Capful/Graduation_Project/堆肥发酵塔设计/PPT 素材/有加强_转.gif

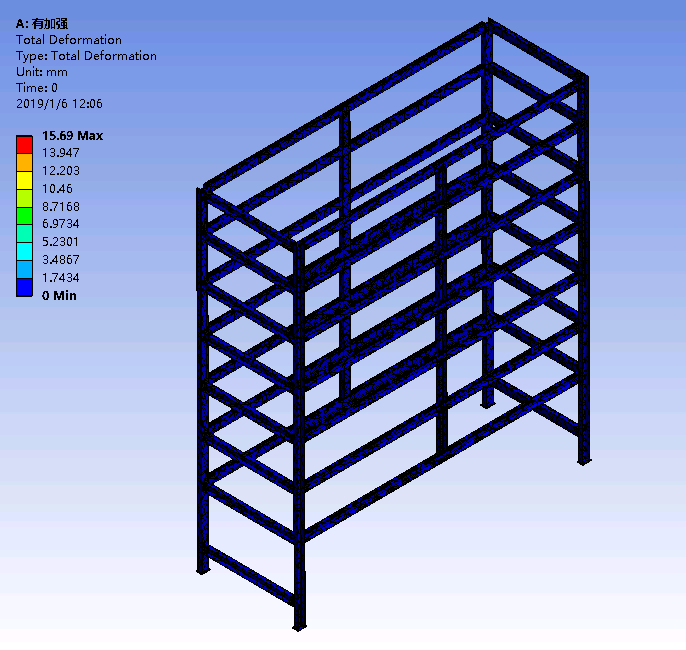
堆肥发酵塔设计/PPT 素材/有加强_转.gif
