Capful/Graduation_Project/堆肥发酵塔设计/ANSYS分析/截图/受力面.png

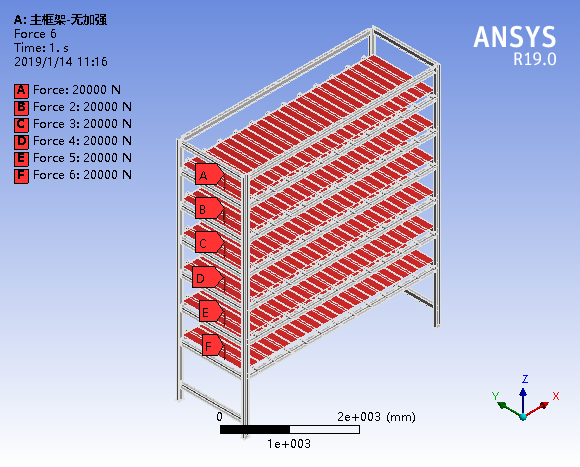
堆肥发酵塔设计/ANSYS分析/截图/受力面.png
