Capful/Graduation_Project/堆肥发酵塔设计/ANSYS分析/截图/总变形-无加强.png

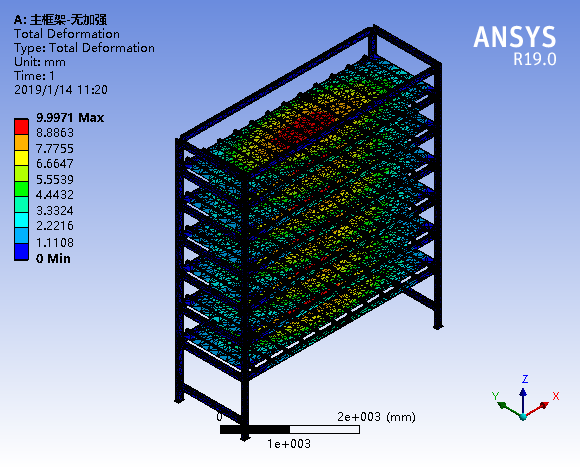
堆肥发酵塔设计/ANSYS分析/截图/总变形-无加强.png
