Capful/Graduation_Project/堆肥发酵塔设计/PPT 素材/QQ截图20190106104016.png

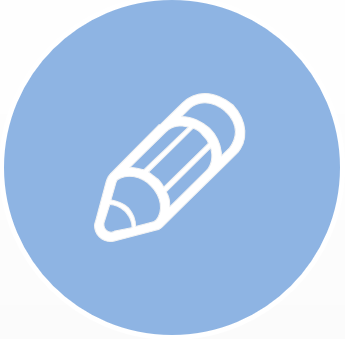
堆肥发酵塔设计/PPT 素材/QQ截图20190106104016.png
