Capful/Graduation_Project/堆肥发酵塔设计/PPT 素材/timg.jpg

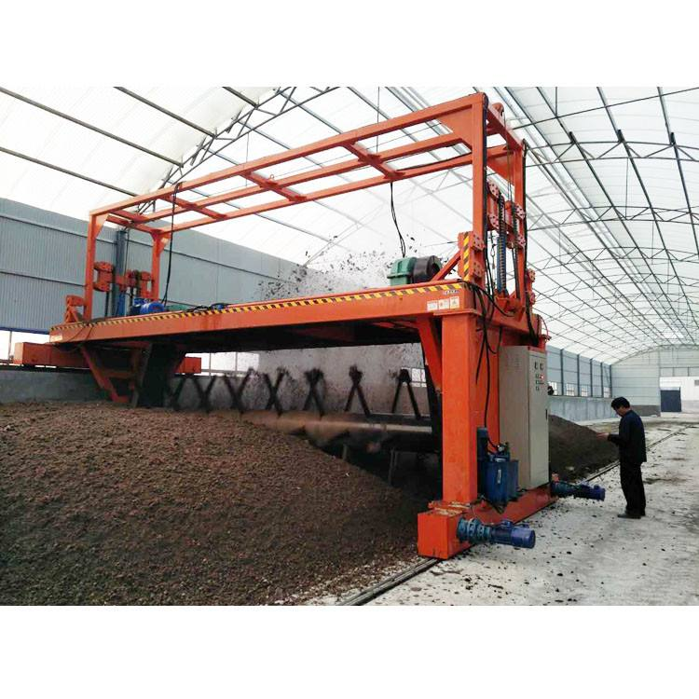
堆肥发酵塔设计/PPT 素材/timg.jpg
