Capful/Graduation_Project/堆肥发酵塔设计/PPT 素材/附件13：配色10 - 副本.png

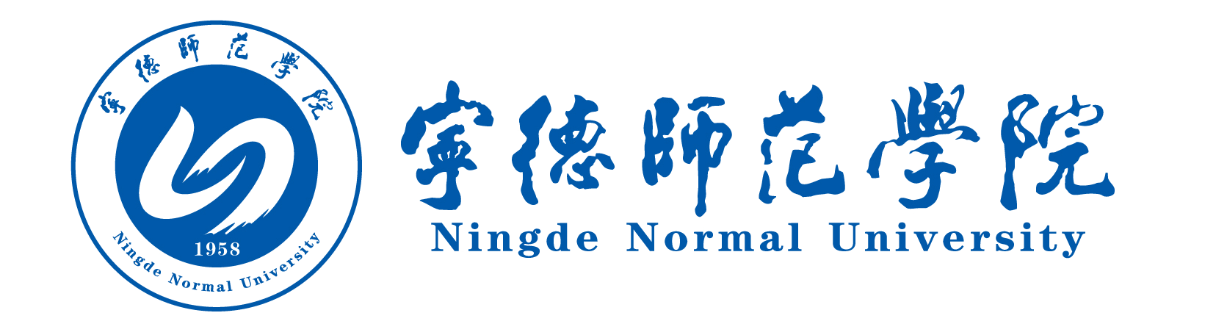
堆肥发酵塔设计/PPT 素材/附件13：配色10 - 副本.png
