Capful/Graduation_Project/堆肥发酵塔设计/堆肥发酵塔2D图/2D PDF/FJT-01001(横支架).jpg

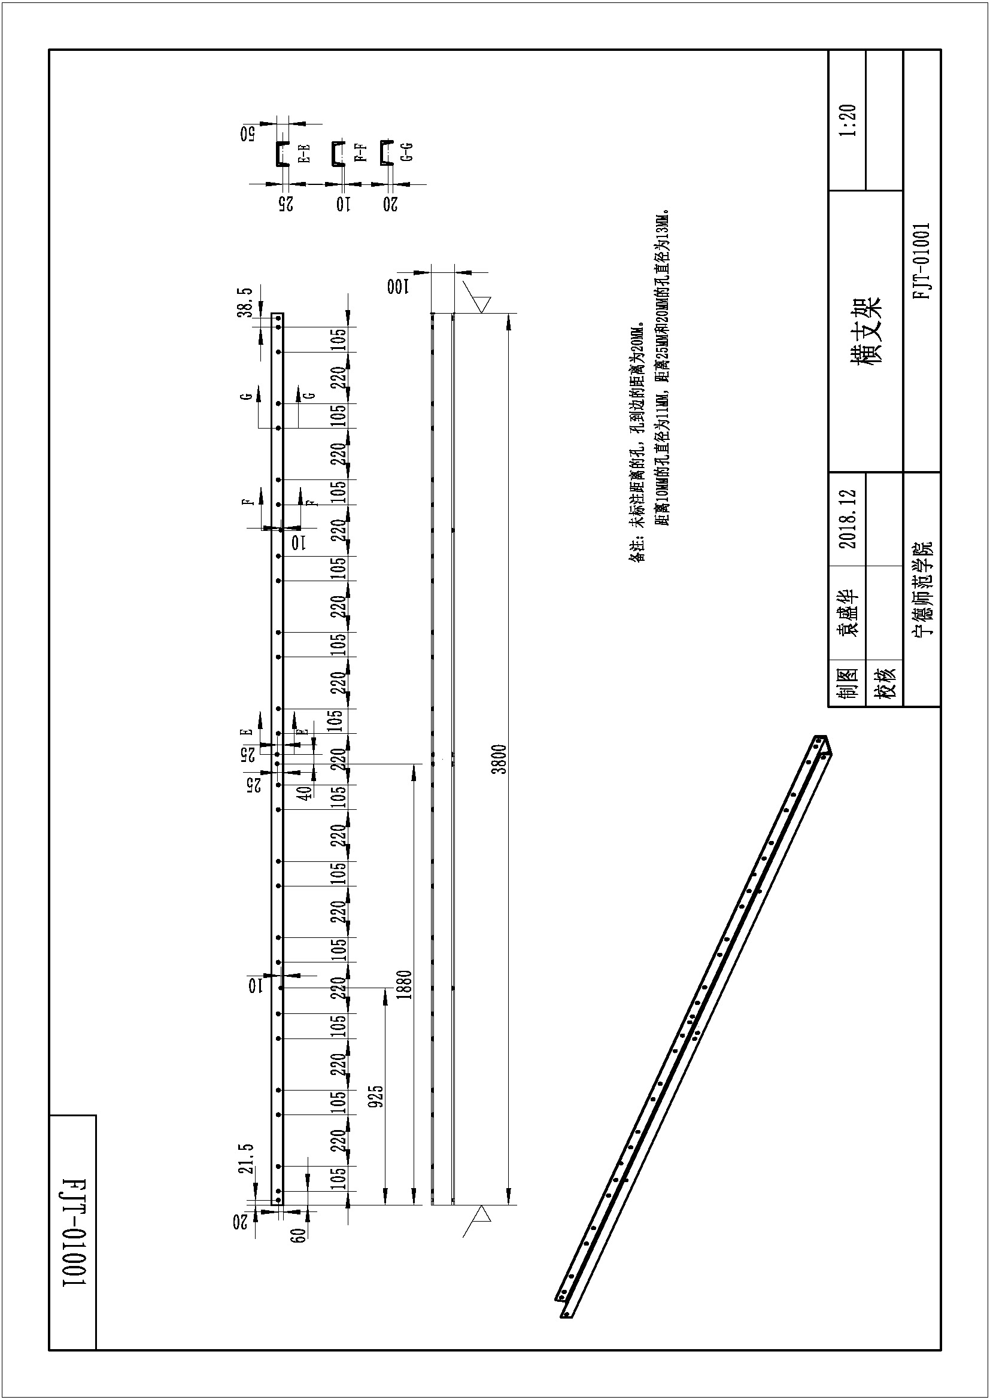
堆肥发酵塔设计/堆肥发酵塔2D图/2D PDF/FJT-01001(横支架).jpg
