Capful/Graduation_Project/堆肥发酵塔设计/堆肥发酵塔2D图/2D PDF/FJT-02100(摆动叶A).jpg

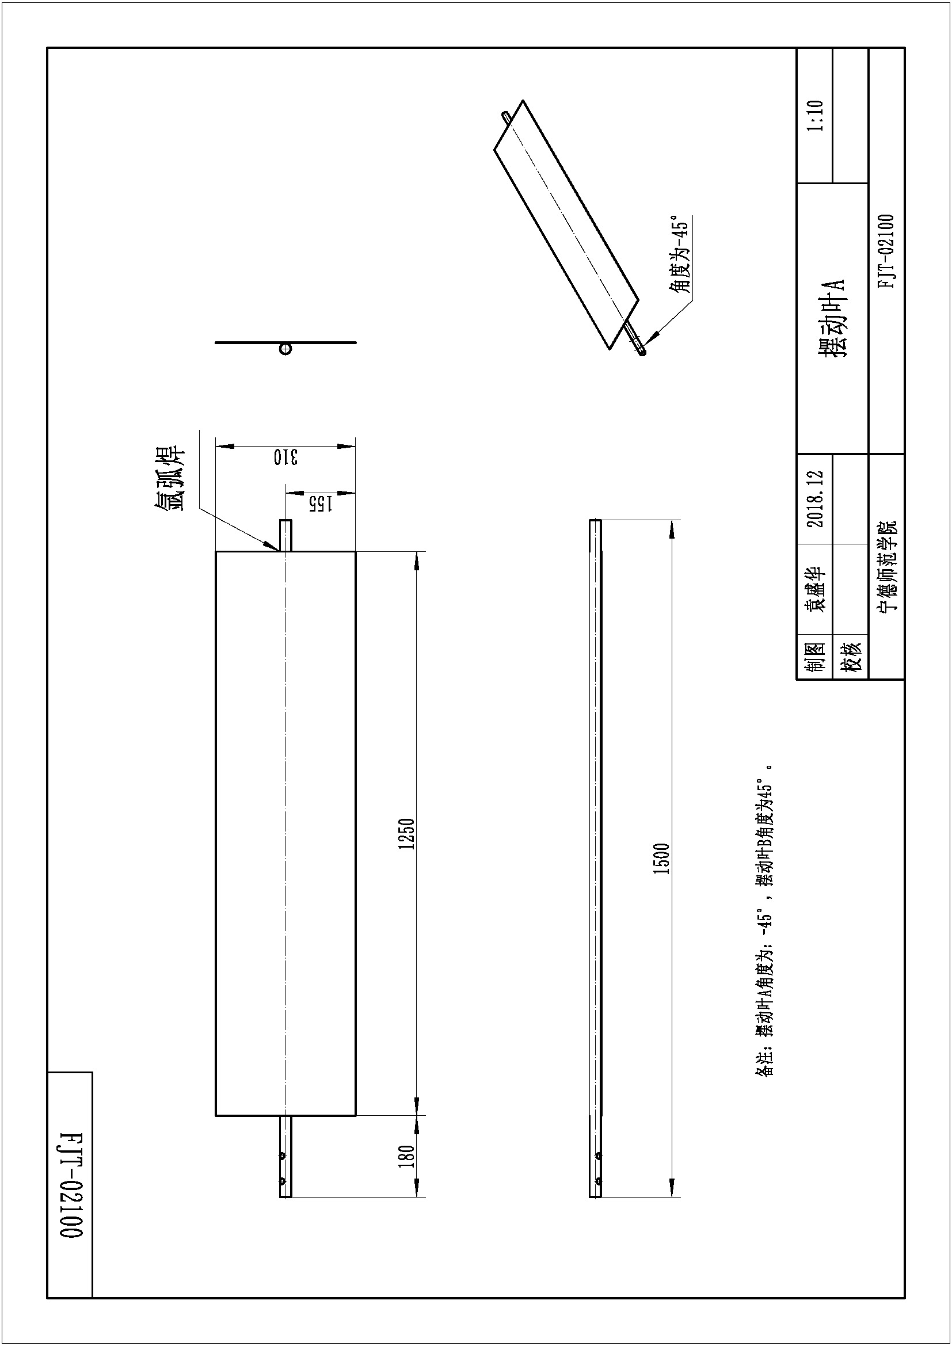
堆肥发酵塔设计/堆肥发酵塔2D图/2D PDF/FJT-02100(摆动叶A).jpg
