Capful/Graduation_Project/堆肥发酵塔设计/模型截图/右支架.png

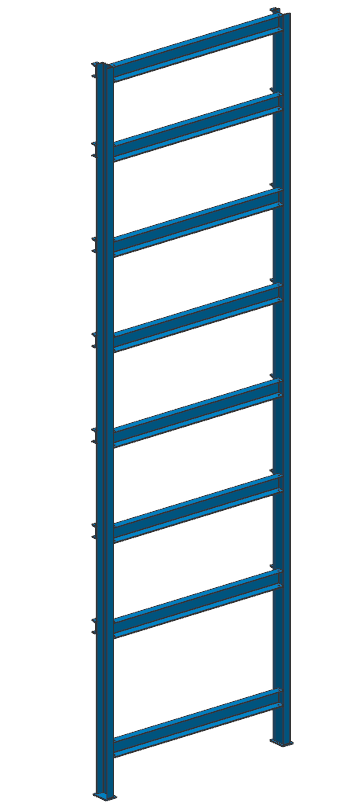
堆肥发酵塔设计/模型截图/右支架.png
