Capful/Graduation_Project/堆肥发酵塔设计/模型截图/左右支架2D.png

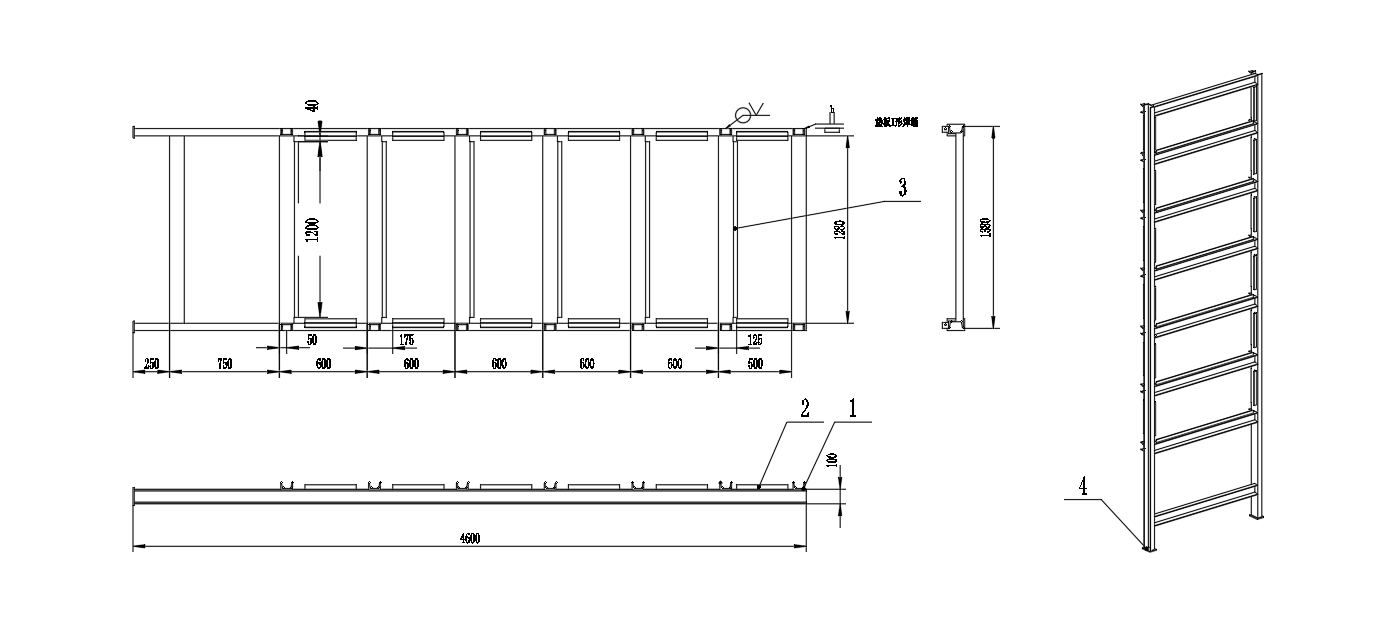
堆肥发酵塔设计/模型截图/左右支架2D.png
