Capful/Graduation_Project/堆肥发酵塔设计/模型截图/机构简图2.png

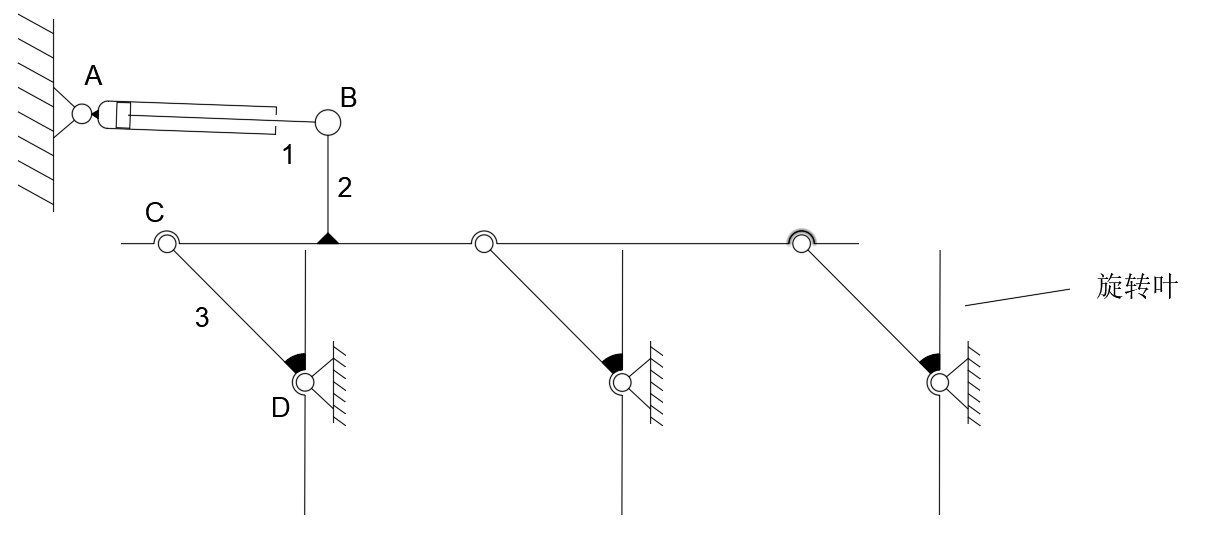
堆肥发酵塔设计/模型截图/机构简图2.png
