Capful/Graduation_Project/堆肥发酵塔设计/模型截图/横支架连接.png

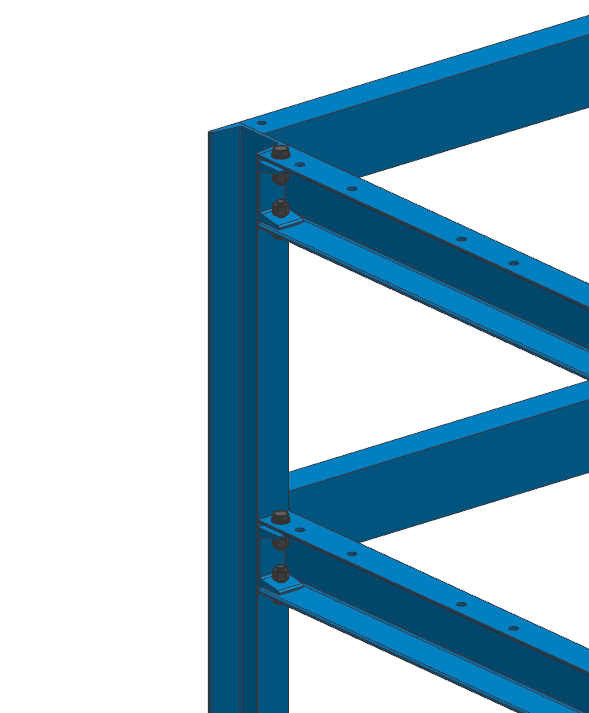
堆肥发酵塔设计/模型截图/横支架连接.png
