Capful/Graduation_Project/堆肥发酵塔设计/模型截图/油缸伸出长度.png

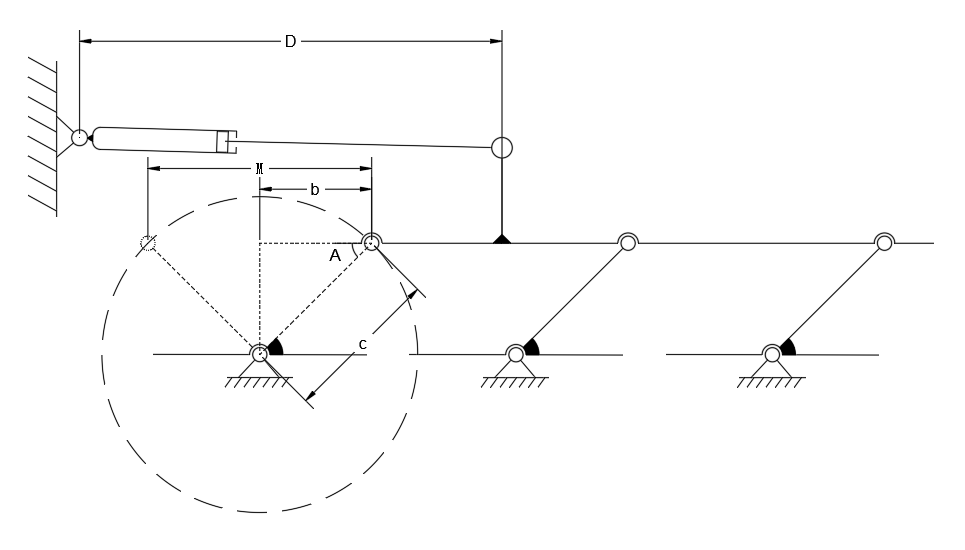
堆肥发酵塔设计/模型截图/油缸伸出长度.png
