Capful/Graduation_Project/堆肥发酵塔设计/模型截图/液压油缸2d2.png

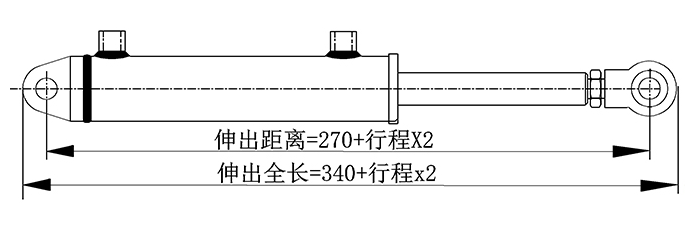
堆肥发酵塔设计/模型截图/液压油缸2d2.png
