Capful/Graduation_Project/堆肥发酵塔设计/模型截图/示意图.png

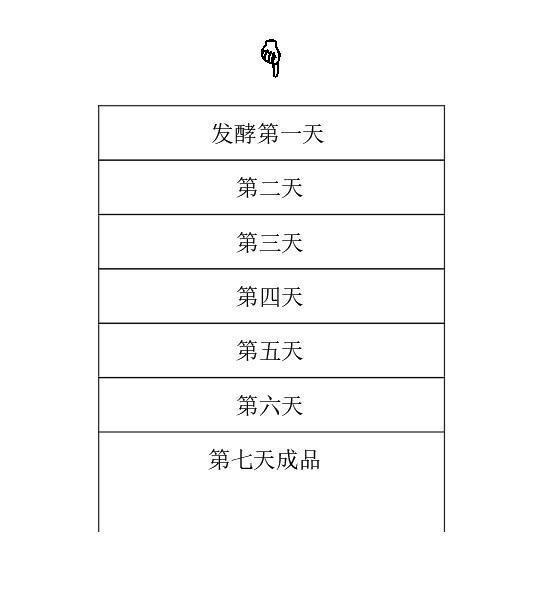
堆肥发酵塔设计/模型截图/示意图.png
