Capful/Graduation_Project/堆肥发酵塔设计/模型截图/移动杆.png

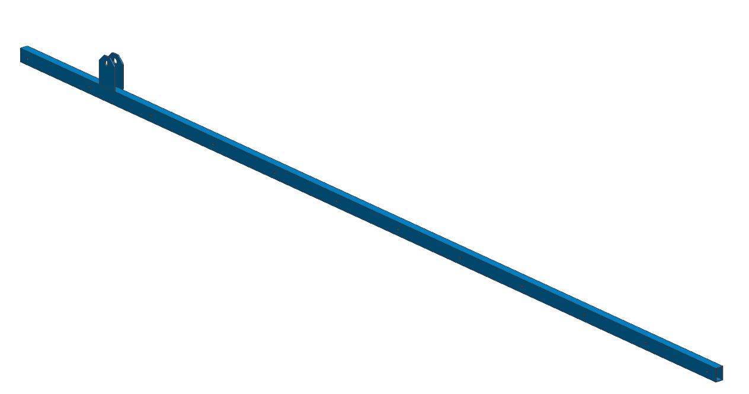
堆肥发酵塔设计/模型截图/移动杆.png
