Capful/Graduation_Project/堆肥发酵塔设计/模型截图/螺栓固定.png

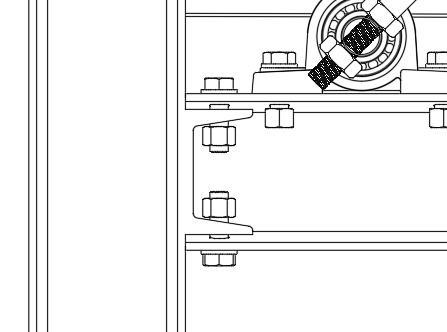
堆肥发酵塔设计/模型截图/螺栓固定.png
