Capful/Graduation_Project/堆肥发酵塔设计/模型截图/运动2D.png

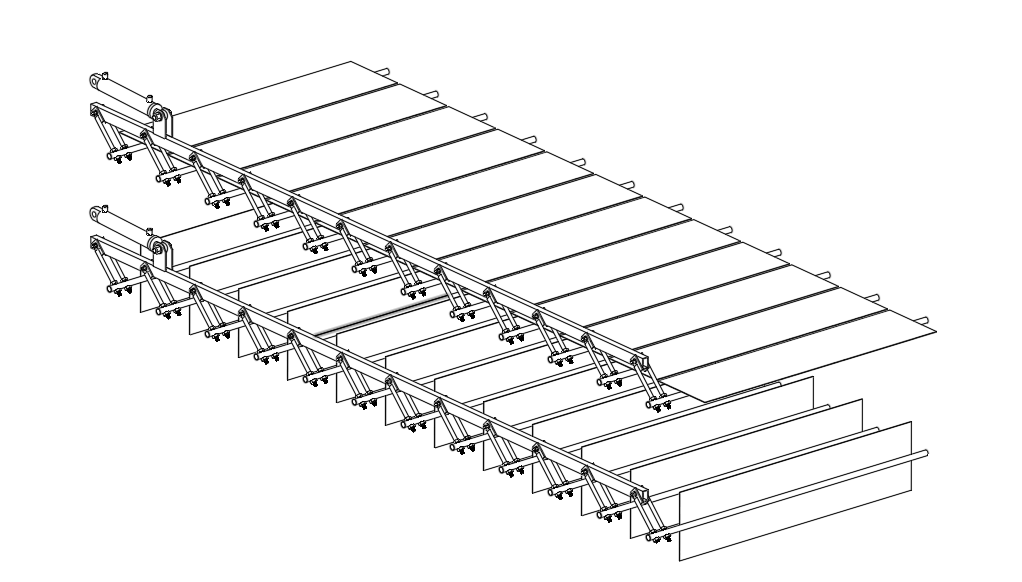
堆肥发酵塔设计/模型截图/运动2D.png
