Capful/Graduation_Project/(list of files, cad)

Other CAD files:
堆肥发酵塔设计/堆肥发酵塔2D图/AutoCAD 2018/FJT-01300(竖支架).dwg
堆肥发酵塔设计/模型截图/自由度.dwg
堆肥发酵塔设计/堆肥发酵塔2D图/AutoCAD 2018/FJT-01200(左支架).dwg
堆肥发酵塔设计/模型截图/卸料设计方案.dwg
堆肥发酵塔设计/堆肥发酵塔2D图/AutoCAD 2018/FJT-01100(右支架).dwg
堆肥发酵塔设计/模型截图/示意图.dwg
堆肥发酵塔设计/堆肥发酵塔2D图/AutoCAD 2018/FJT-01104(垫片).dwg
堆肥发酵塔设计/堆肥发酵塔2D图/AutoCAD 2018/FJT-01101(支架固定块).dwg
堆肥发酵塔设计/堆肥发酵塔2D图/AutoCAD 2018/FJT-02200(摆动叶A-B).dwg
堆肥发酵塔设计/堆肥发酵塔2D图/AutoCAD 2018/FJT-01000(主框架装配).dwg
堆肥发酵塔设计/堆肥发酵塔2D图/AutoCAD 2018/FJT-01002(挡板固定片,横支架).dwg
堆肥发酵塔设计/堆肥发酵塔2D图/AutoCAD 2018/FJT-01005(挡板1).dwg
堆肥发酵塔设计/堆肥发酵塔2D图/AutoCAD 2018/FJT-01102(挡板固定板).dwg
堆肥发酵塔设计/堆肥发酵塔2D图/AutoCAD 2018/FJT-01004(挡板).dwg
堆肥发酵塔设计/ANSYS分析/ANSYS_主框架_加强.prt
堆肥发酵塔设计/ANSYS分析/ANSYS_主框架_无加强.prt
堆肥发酵塔设计/堆肥发酵塔三维模型/3D图/UG12-堆肥发酵塔3D装配图/3D堆肥发酵塔.prt
堆肥发酵塔设计/堆肥发酵塔三维模型/3D图/UG12-堆肥发酵塔3D装配图/63X35X250液压缸.prt
堆肥发酵塔设计/堆肥发酵塔三维模型/3D图/UG12-堆肥发酵塔3D装配图/M10X20螺栓.prt
堆肥发酵塔设计/堆肥发酵塔三维模型/3D图/UG12-堆肥发酵塔3D装配图/M10X30螺杆.prt
堆肥发酵塔设计/堆肥发酵塔三维模型/3D图/UG12-堆肥发酵塔3D装配图/M10X30螺栓-2.prt
堆肥发酵塔设计/堆肥发酵塔三维模型/3D图/UG12-堆肥发酵塔3D装配图/M10X30螺栓-3.prt
堆肥发酵塔设计/堆肥发酵塔三维模型/3D图/UG12-堆肥发酵塔3D装配图/M10X30螺栓.prt
堆肥发酵塔设计/堆肥发酵塔三维模型/3D图/UG12-堆肥发酵塔3D装配图/M10X40螺杆.prt
堆肥发酵塔设计/堆肥发酵塔三维模型/3D图/UG12-堆肥发酵塔3D装配图/M10X40螺栓.prt
堆肥发酵塔设计/堆肥发酵塔三维模型/3D图/UG12-堆肥发酵塔3D装配图/M10X50螺栓.prt
堆肥发酵塔设计/堆肥发酵塔三维模型/3D图/UG12-堆肥发酵塔3D装配图/M10X60螺杆.prt
堆肥发酵塔设计/堆肥发酵塔三维模型/3D图/UG12-堆肥发酵塔3D装配图/M10X60螺栓.prt
堆肥发酵塔设计/堆肥发酵塔三维模型/3D图/UG12-堆肥发酵塔3D装配图/M10平垫圈.prt
堆肥发酵塔设计/堆肥发酵塔三维模型/3D图/UG12-堆肥发酵塔3D装配图/M10螺母.prt
堆肥发酵塔设计/堆肥发酵塔三维模型/3D图/UG12-堆肥发酵塔3D装配图/M12X40螺杆.prt
堆肥发酵塔设计/堆肥发酵塔三维模型/3D图/UG12-堆肥发酵塔3D装配图/M12X40螺栓-2.prt
堆肥发酵塔设计/堆肥发酵塔三维模型/3D图/UG12-堆肥发酵塔3D装配图/M12X40螺栓.prt
堆肥发酵塔设计/堆肥发酵塔三维模型/3D图/UG12-堆肥发酵塔3D装配图/M12平垫圈.prt
堆肥发酵塔设计/堆肥发酵塔三维模型/3D图/UG12-堆肥发酵塔3D装配图/M12螺母.prt
堆肥发酵塔设计/堆肥发酵塔三维模型/3D图/UG12-堆肥发酵塔3D装配图/M14螺母.prt
堆肥发酵塔设计/堆肥发酵塔三维模型/3D图/UG12-堆肥发酵塔3D装配图/M20X70螺杆.prt
堆肥发酵塔设计/堆肥发酵塔三维模型/3D图/UG12-堆肥发酵塔3D装配图/M20X70螺栓.prt
堆肥发酵塔设计/堆肥发酵塔三维模型/3D图/UG12-堆肥发酵塔3D装配图/M20X90螺杆.prt
堆肥发酵塔设计/堆肥发酵塔三维模型/3D图/UG12-堆肥发酵塔3D装配图/M20X90螺栓.prt
堆肥发酵塔设计/堆肥发酵塔三维模型/3D图/UG12-堆肥发酵塔3D装配图/M20平垫圈.prt
堆肥发酵塔设计/堆肥发酵塔三维模型/3D图/UG12-堆肥发酵塔3D装配图/M20螺母.prt
堆肥发酵塔设计/堆肥发酵塔三维模型/3D图/UG12-堆肥发酵塔3D装配图/M6螺钉.prt
堆肥发酵塔设计/堆肥发酵塔三维模型/3D图/UG12-堆肥发酵塔3D装配图/P205轴承座.prt
堆肥发酵塔设计/堆肥发酵塔三维模型/3D图/UG12-堆肥发酵塔3D装配图/UB205轴承.prt
堆肥发酵塔设计/堆肥发酵塔三维模型/3D图/UG12-堆肥发酵塔3D装配图/主支架.prt
堆肥发酵塔设计/堆肥发酵塔三维模型/3D图/UG12-堆肥发酵塔3D装配图/主框架.prt
堆肥发酵塔设计/堆肥发酵塔三维模型/3D图/UG12-堆肥发酵塔3D装配图/主横支架.prt
堆肥发酵塔设计/堆肥发酵塔三维模型/3D图/UG12-堆肥发酵塔3D装配图/副支架.prt
堆肥发酵塔设计/堆肥发酵塔三维模型/3D图/UG12-堆肥发酵塔3D装配图/挡板1.prt
堆肥发酵塔设计/堆肥发酵塔三维模型/3D图/UG12-堆肥发酵塔3D装配图/挡板2.prt
堆肥发酵塔设计/堆肥发酵塔三维模型/3D图/UG12-堆肥发酵塔3D装配图/挡板3.prt
堆肥发酵塔设计/堆肥发酵塔三维模型/3D图/UG12-堆肥发酵塔3D装配图/挡板4.prt
堆肥发酵塔设计/堆肥发酵塔三维模型/3D图/UG12-堆肥发酵塔3D装配图/挡板固定架-1200.prt
堆肥发酵塔设计/堆肥发酵塔三维模型/3D图/UG12-堆肥发酵塔3D装配图/挡板固定架-350.prt
堆肥发酵塔设计/堆肥发酵塔三维模型/3D图/UG12-堆肥发酵塔3D装配图/挡板固定片-400.prt
堆肥发酵塔设计/堆肥发酵塔三维模型/3D图/UG12-堆肥发酵塔3D装配图/挡板固定片.prt
堆肥发酵塔设计/堆肥发酵塔三维模型/3D图/UG12-堆肥发酵塔3D装配图/支架固定板.prt
堆肥发酵塔设计/堆肥发酵塔三维模型/3D图/UG12-堆肥发酵塔3D装配图/旋转叶-45.prt
堆肥发酵塔设计/堆肥发酵塔三维模型/3D图/UG12-堆肥发酵塔3D装配图/旋转叶.prt
堆肥发酵塔设计/堆肥发酵塔三维模型/3D图/UG12-堆肥发酵塔3D装配图/横支架.prt
堆肥发酵塔设计/堆肥发酵塔三维模型/3D图/UG12-堆肥发酵塔3D装配图/油缸.prt
堆肥发酵塔设计/堆肥发酵塔三维模型/3D图/UG12-堆肥发酵塔3D装配图/液压缸伸缩杆.prt
堆肥发酵塔设计/堆肥发酵塔三维模型/3D图/UG12-堆肥发酵塔3D装配图/液压缸固定板.prt
堆肥发酵塔设计/堆肥发酵塔三维模型/3D图/UG12-堆肥发酵塔3D装配图/液压缸控制器.prt
堆肥发酵塔设计/堆肥发酵塔三维模型/3D图/UG12-堆肥发酵塔3D装配图/移动杆-45.prt
堆肥发酵塔设计/堆肥发酵塔三维模型/3D图/UG12-堆肥发酵塔3D装配图/移动杆.prt
堆肥发酵塔设计/堆肥发酵塔三维模型/3D图/UG12-堆肥发酵塔3D装配图/立式手动液压站.prt
堆肥发酵塔设计/堆肥发酵塔三维模型/3D图/UG12-堆肥发酵塔3D装配图/竖支架.prt
堆肥发酵塔设计/堆肥发酵塔三维模型/3D图/UG12-堆肥发酵塔3D装配图/竖支架2.prt
堆肥发酵塔设计/堆肥发酵塔三维模型/3D图/UG12-堆肥发酵塔3D装配图/角度杆.prt
堆肥发酵塔设计/堆肥发酵塔三维模型/3D图/堆肥发酵塔3D图.x_t
