Capful/Graduation_Project/堆肥发酵塔设计/堆肥发酵塔2D图/2D PDF/FJT-02000(卸料机构装配图).pdf

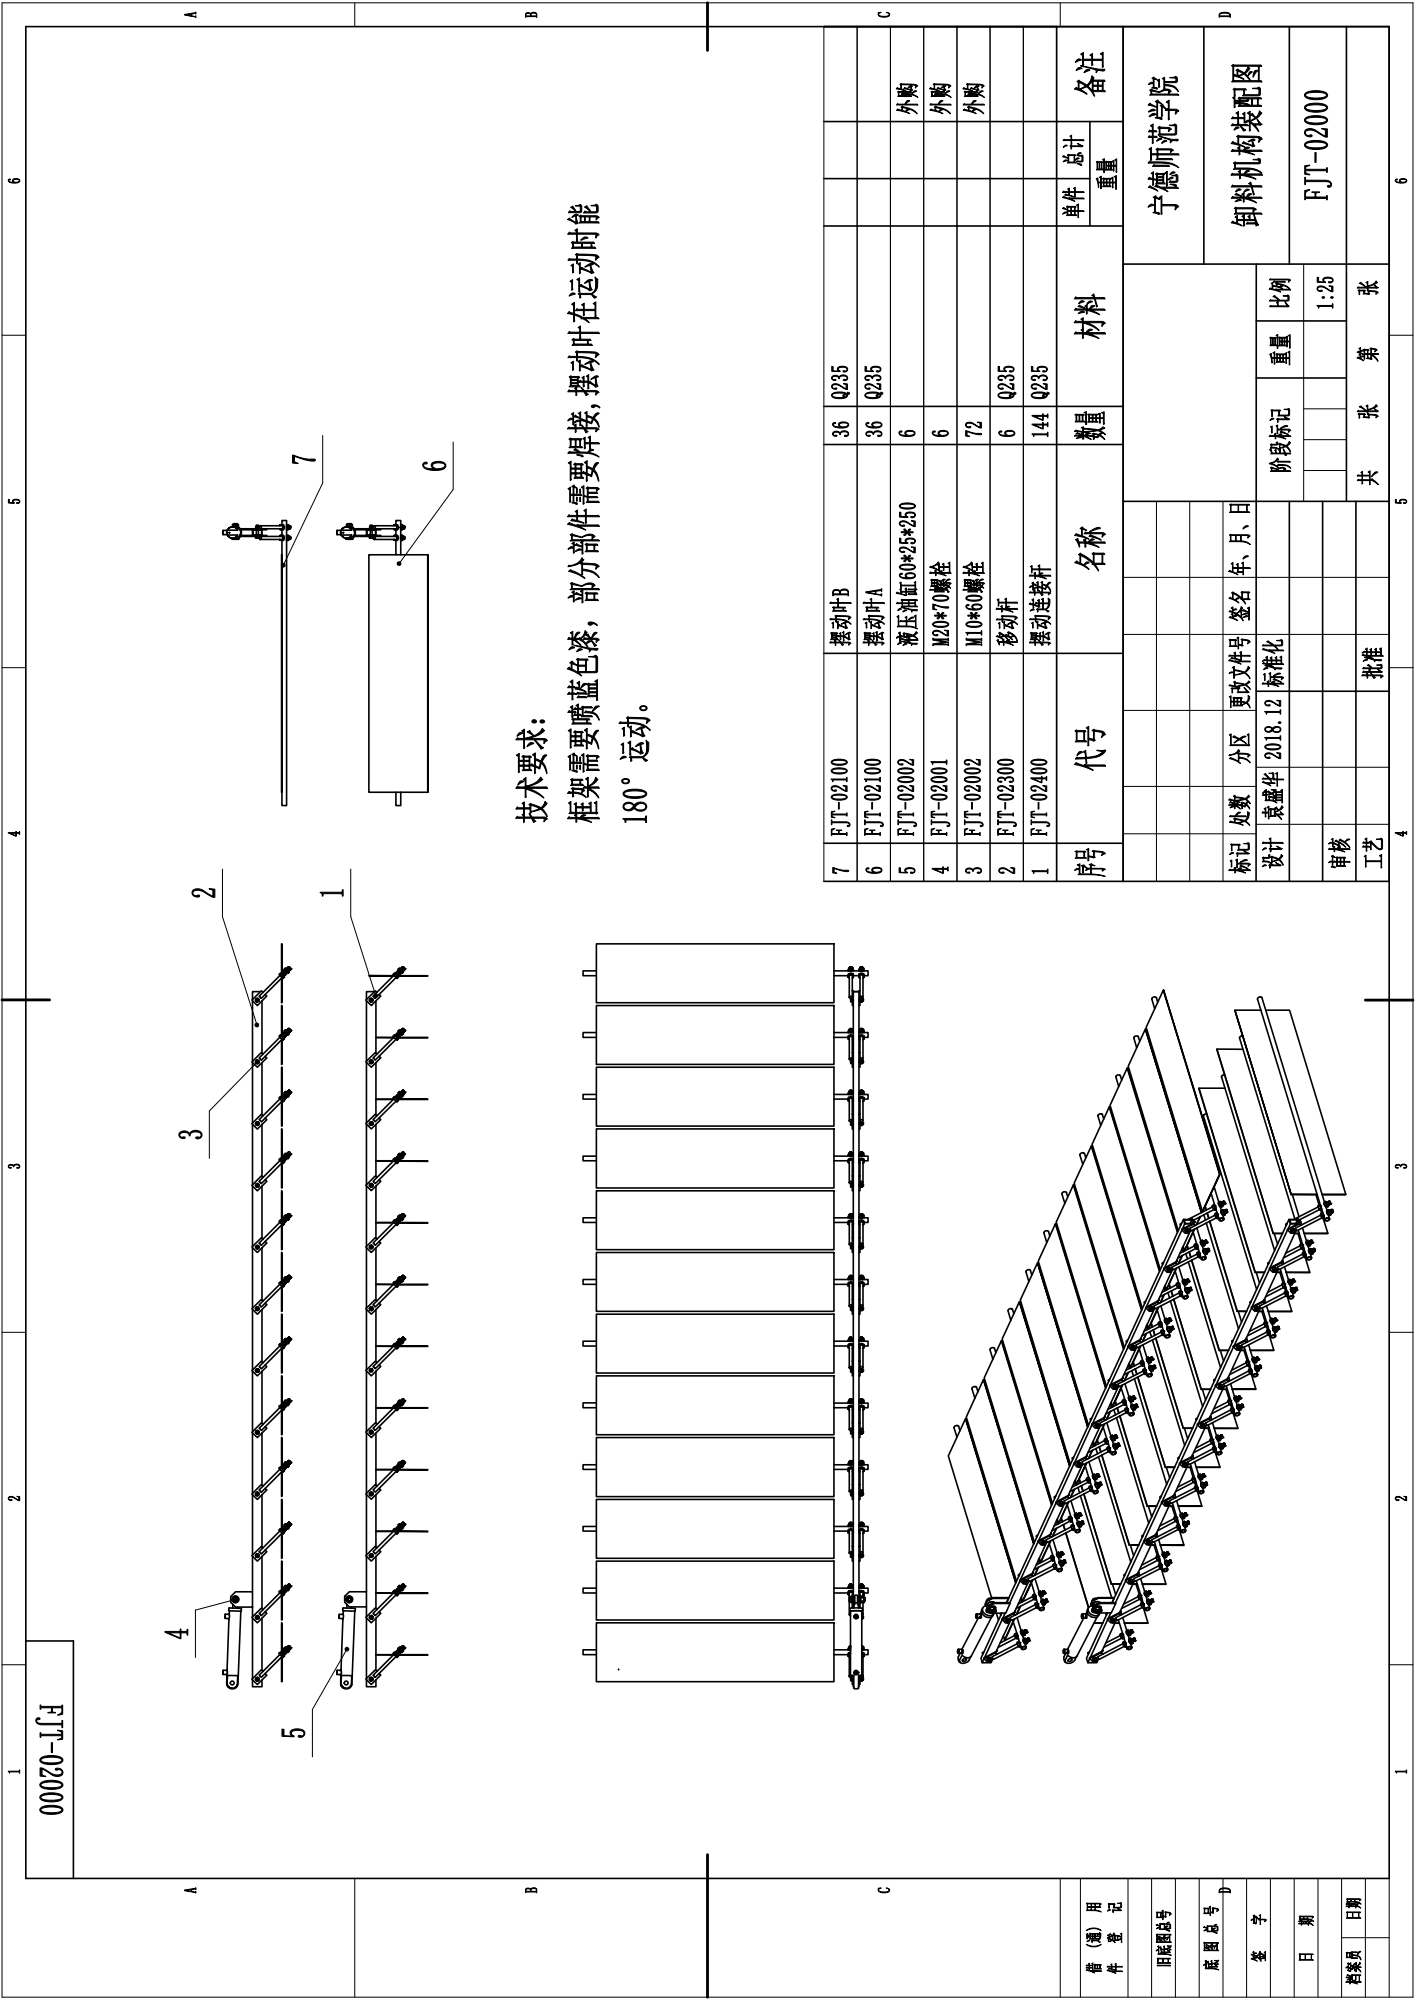
[picture p76: page 1]
