Capful/Graduation_Project/堆肥发酵塔设计/堆肥发酵塔2D图/2D PDF/FJT-01000(主框架装配).pdf

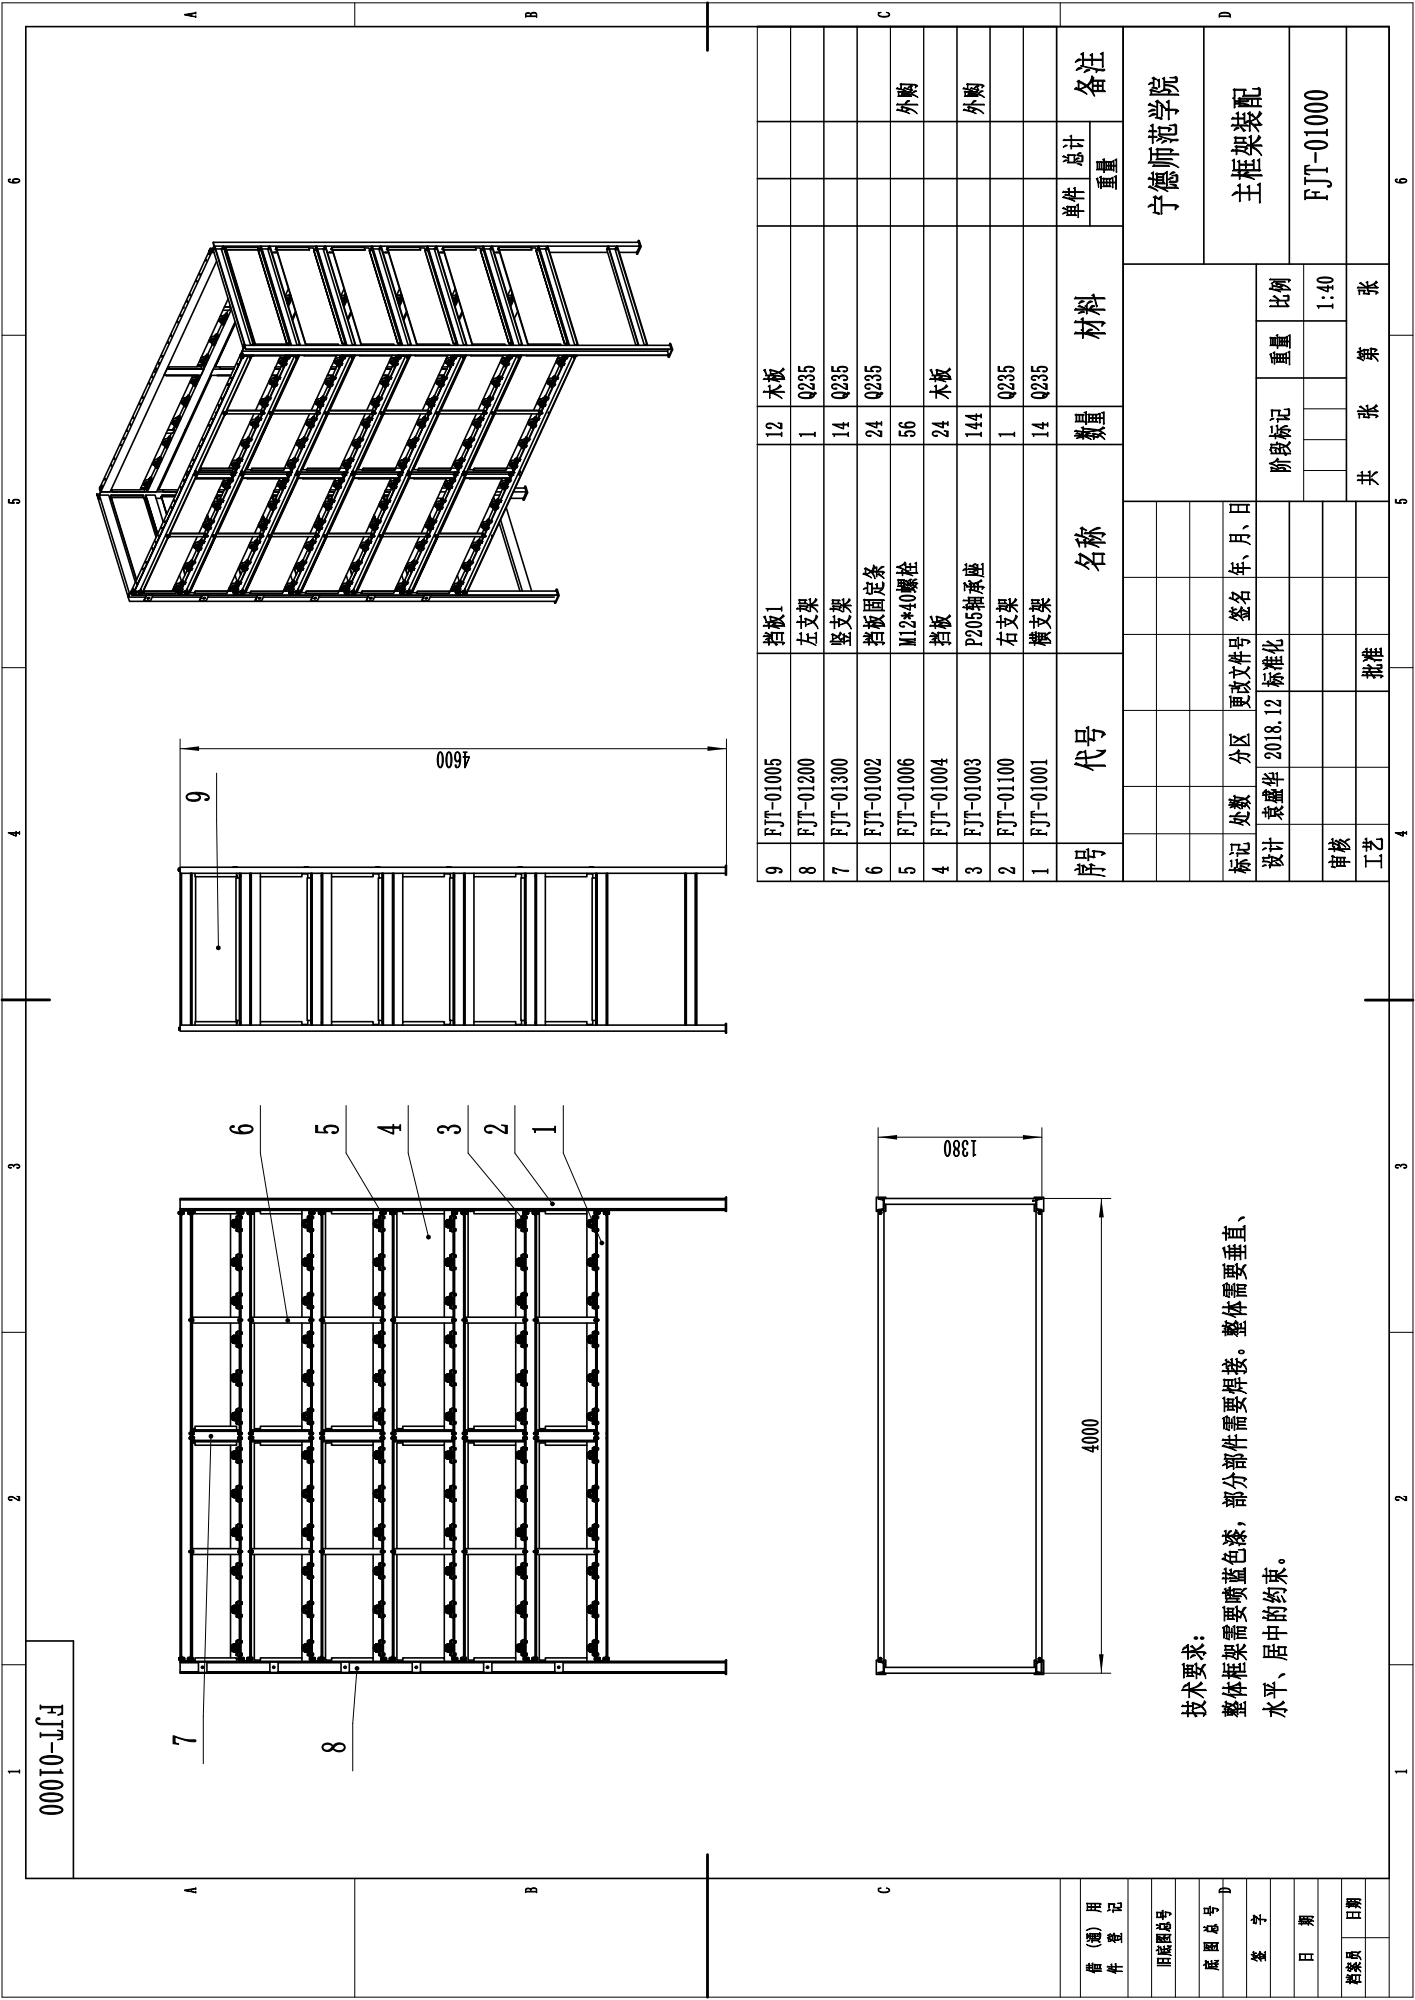
[picture p77: page 1]
