Capful/Graduation_Project/堆肥发酵塔设计/堆肥发酵塔2D图/2D PDF/FJT-001201(油缸固定板).pdf

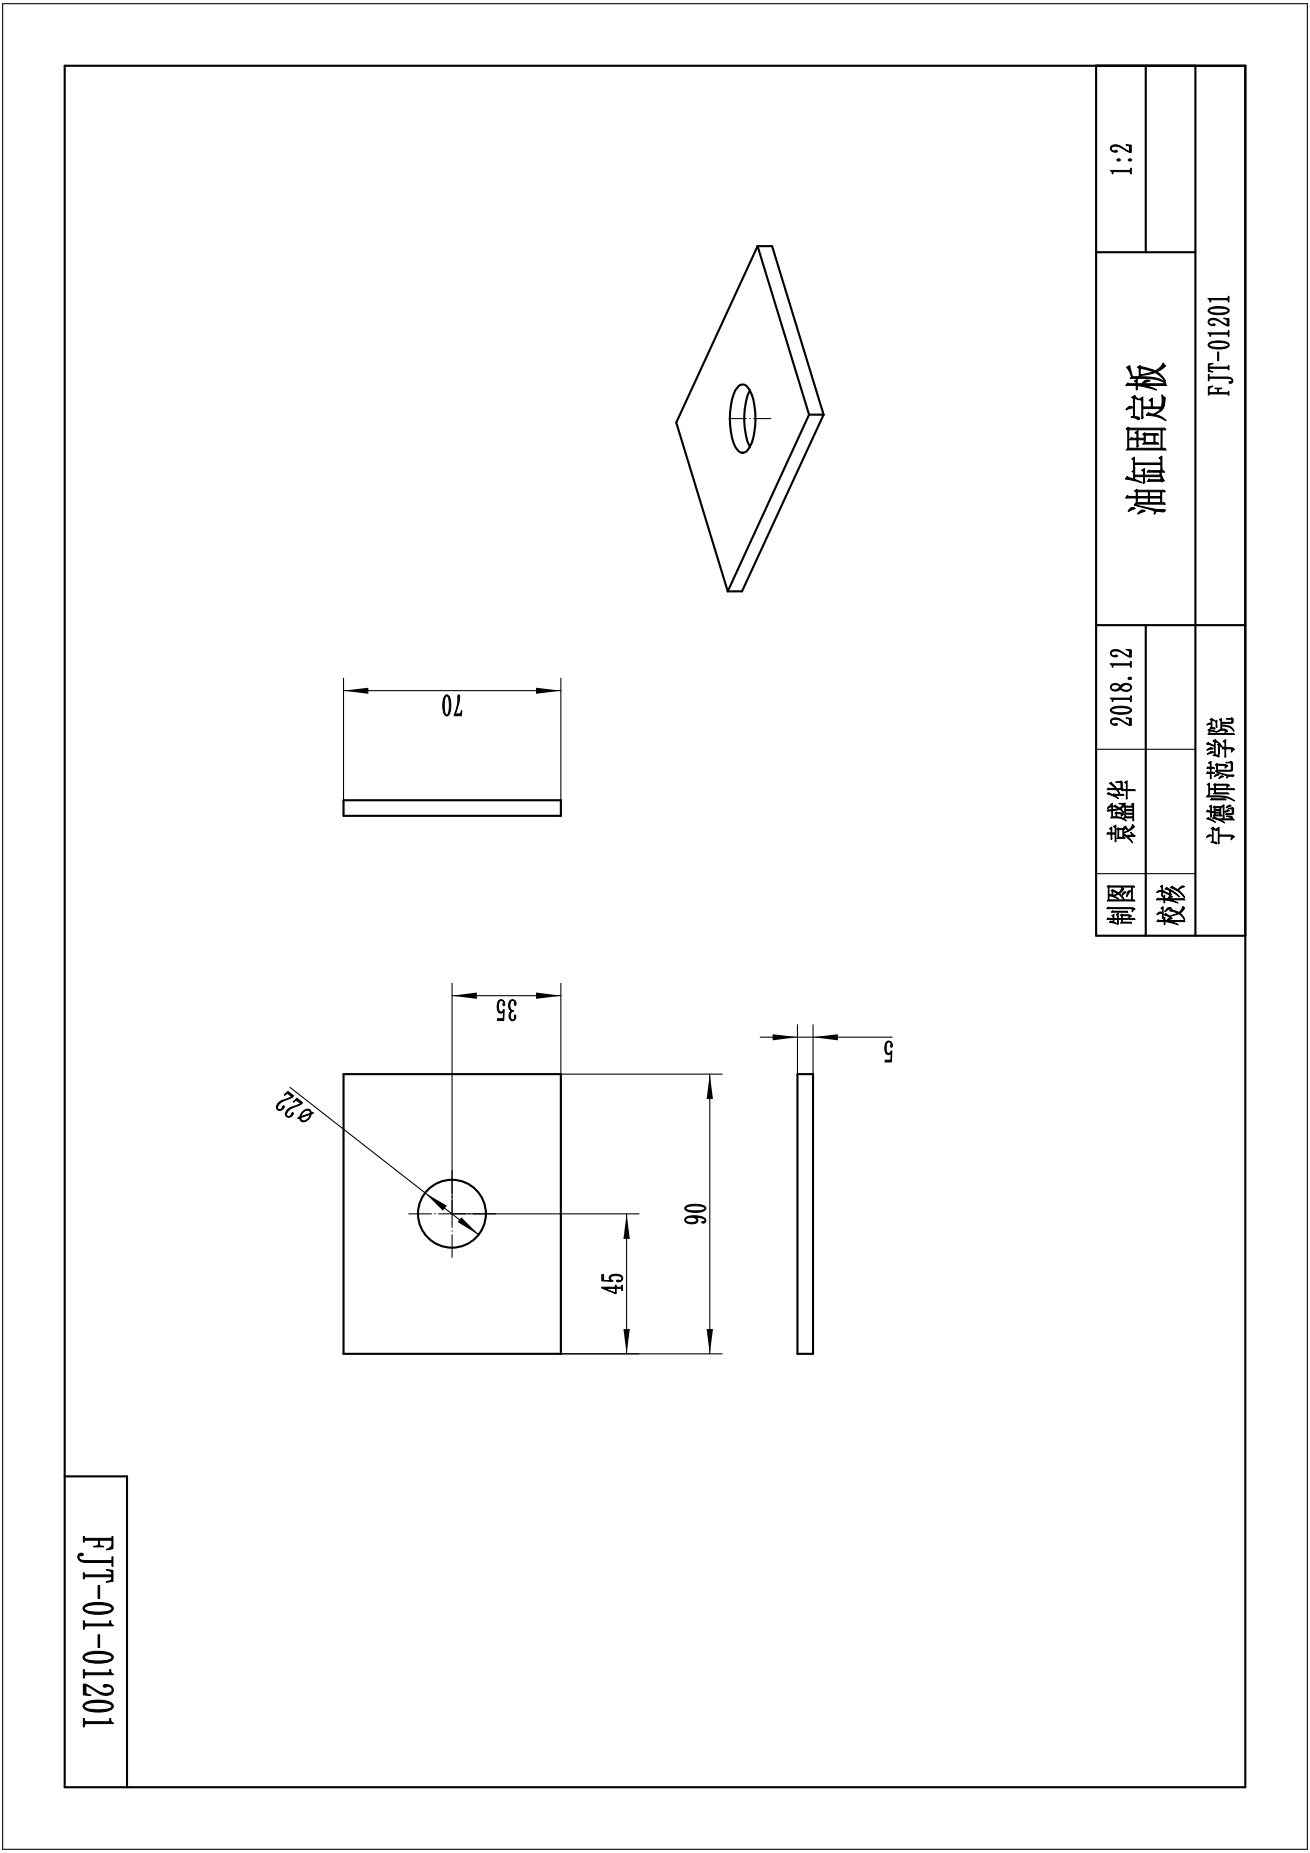
[picture p80: page 1]
