Capful/Graduation_Project/堆肥发酵塔设计/堆肥发酵塔2D图/2D PDF/FJT-01002(挡板固定片).pdf

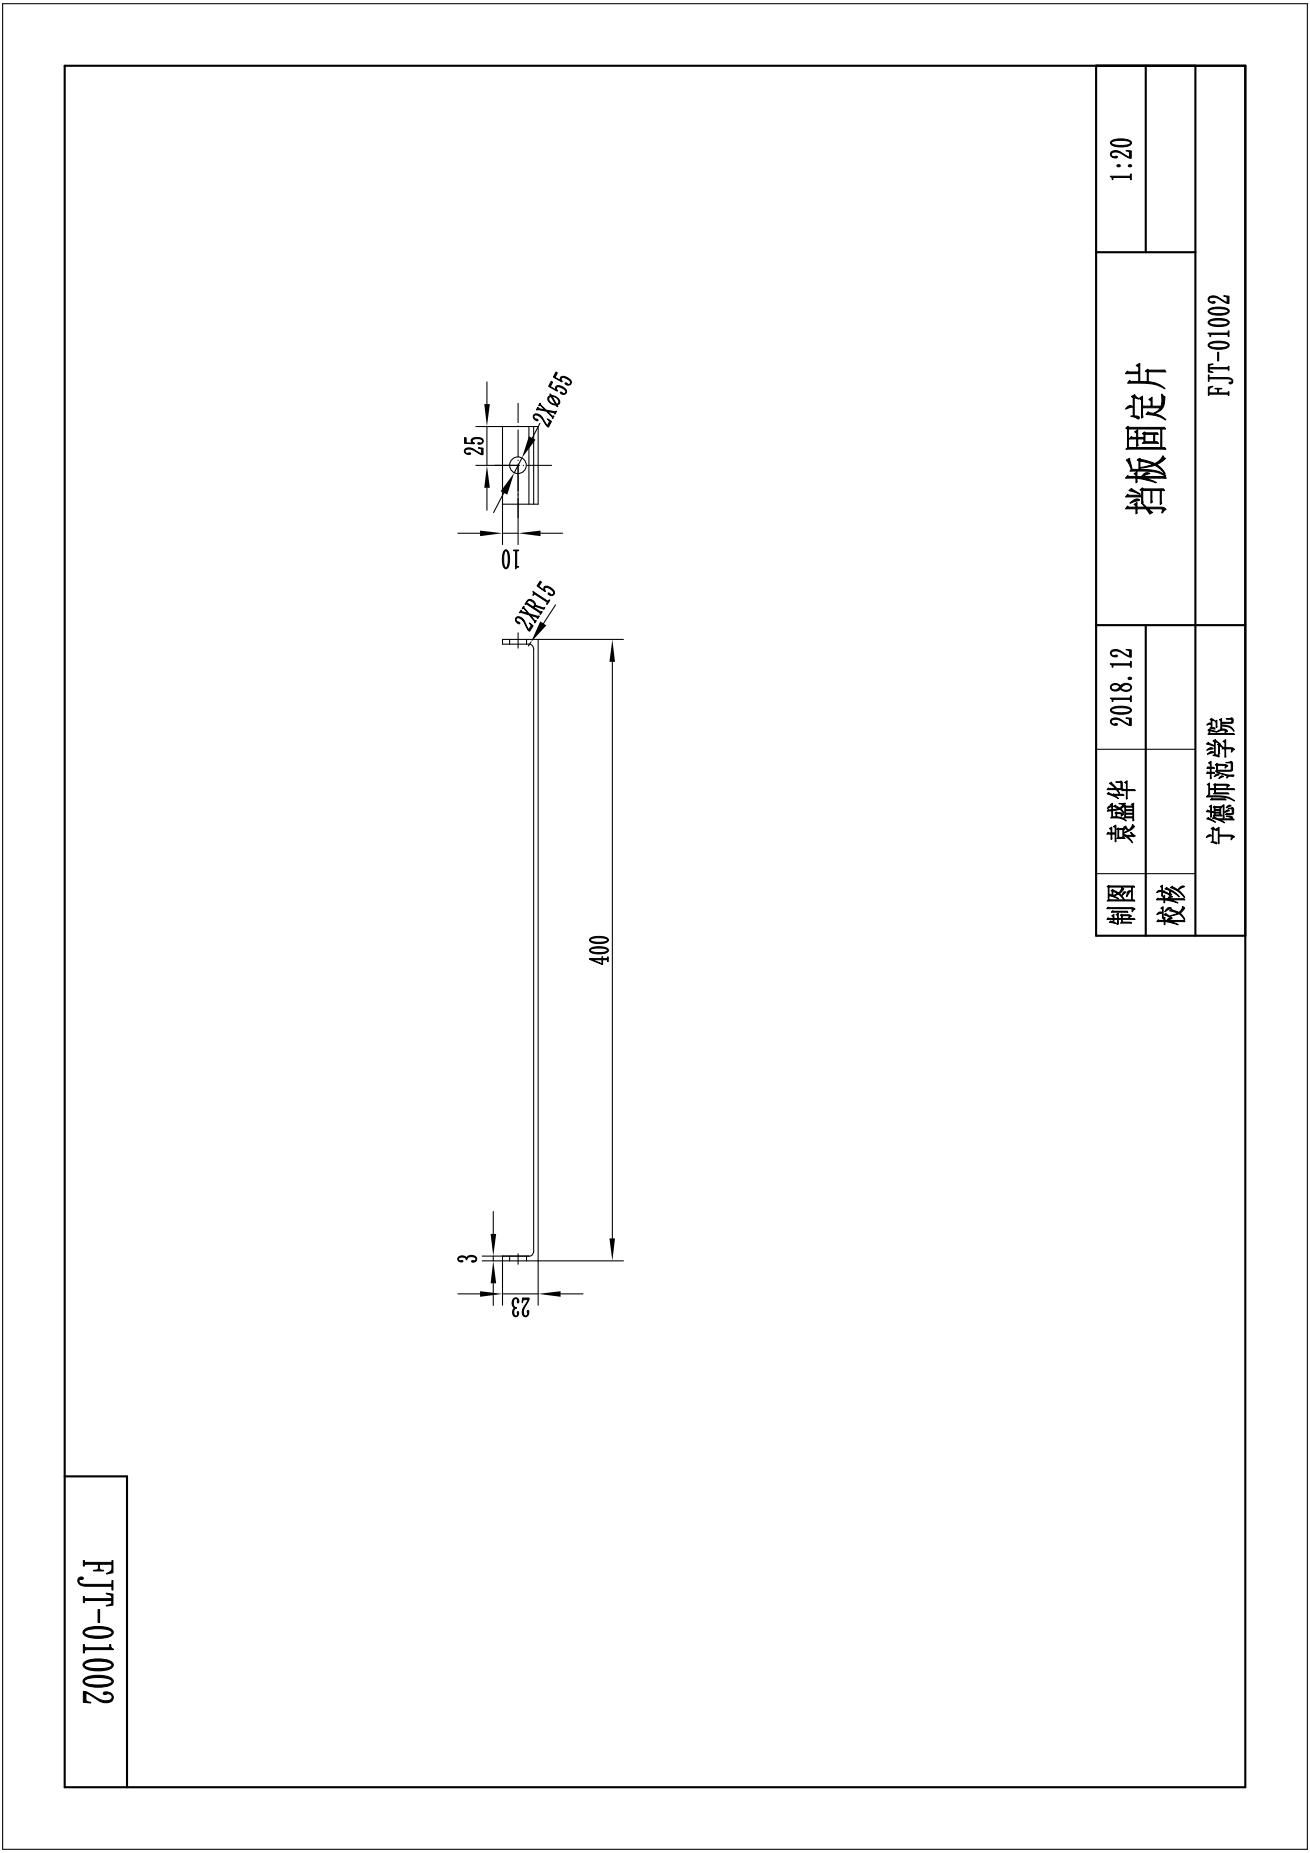
[picture p82: page 1]
