Capful/Graduation_Project/堆肥发酵塔设计/堆肥发酵塔2D图/2D PDF/FJT-01004(挡板).pdf

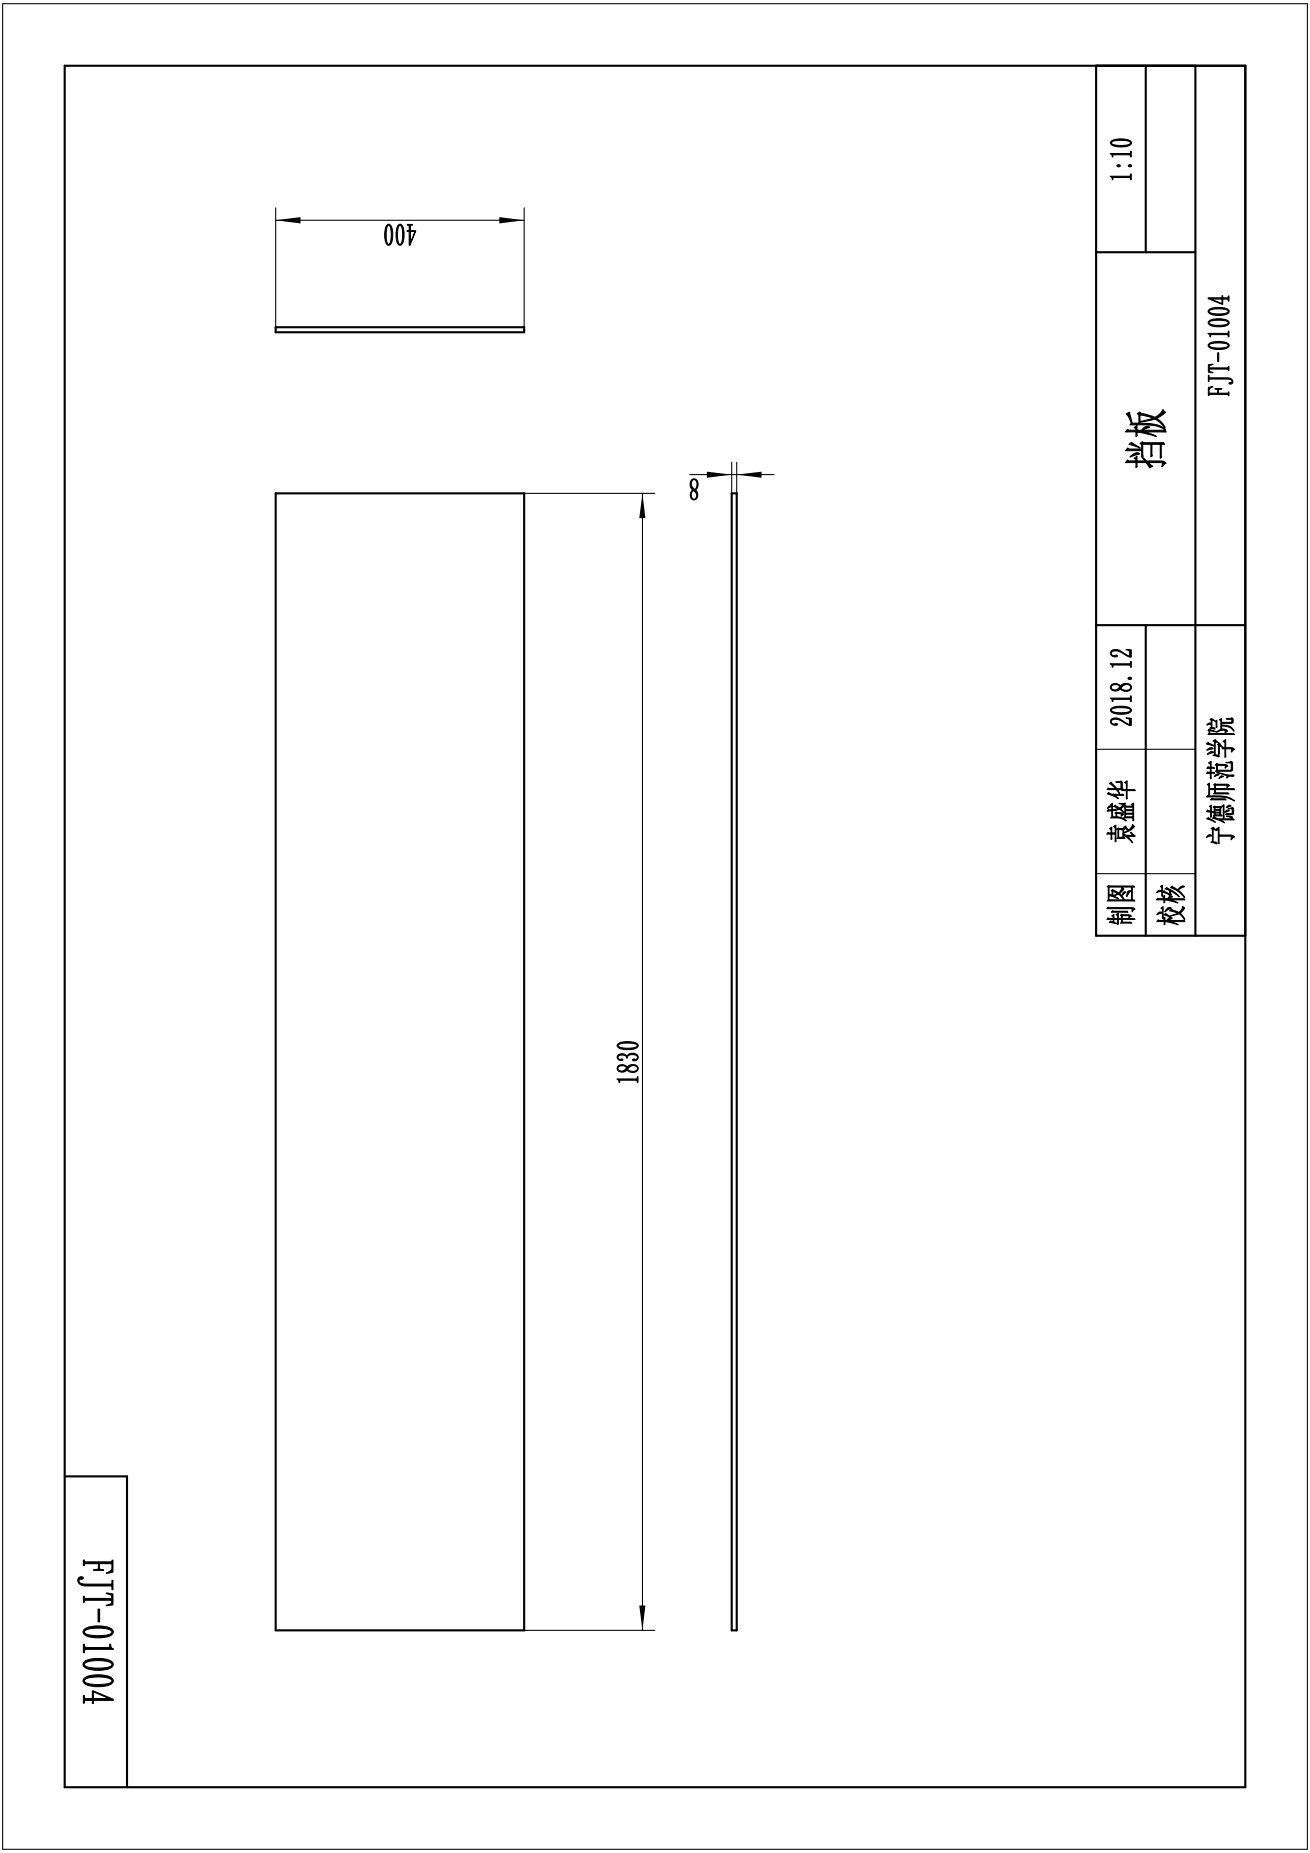
[picture p83: page 1]
