Capful/Graduation_Project/堆肥发酵塔设计/堆肥发酵塔2D图/2D PDF/FJT-01005(挡板1).pdf

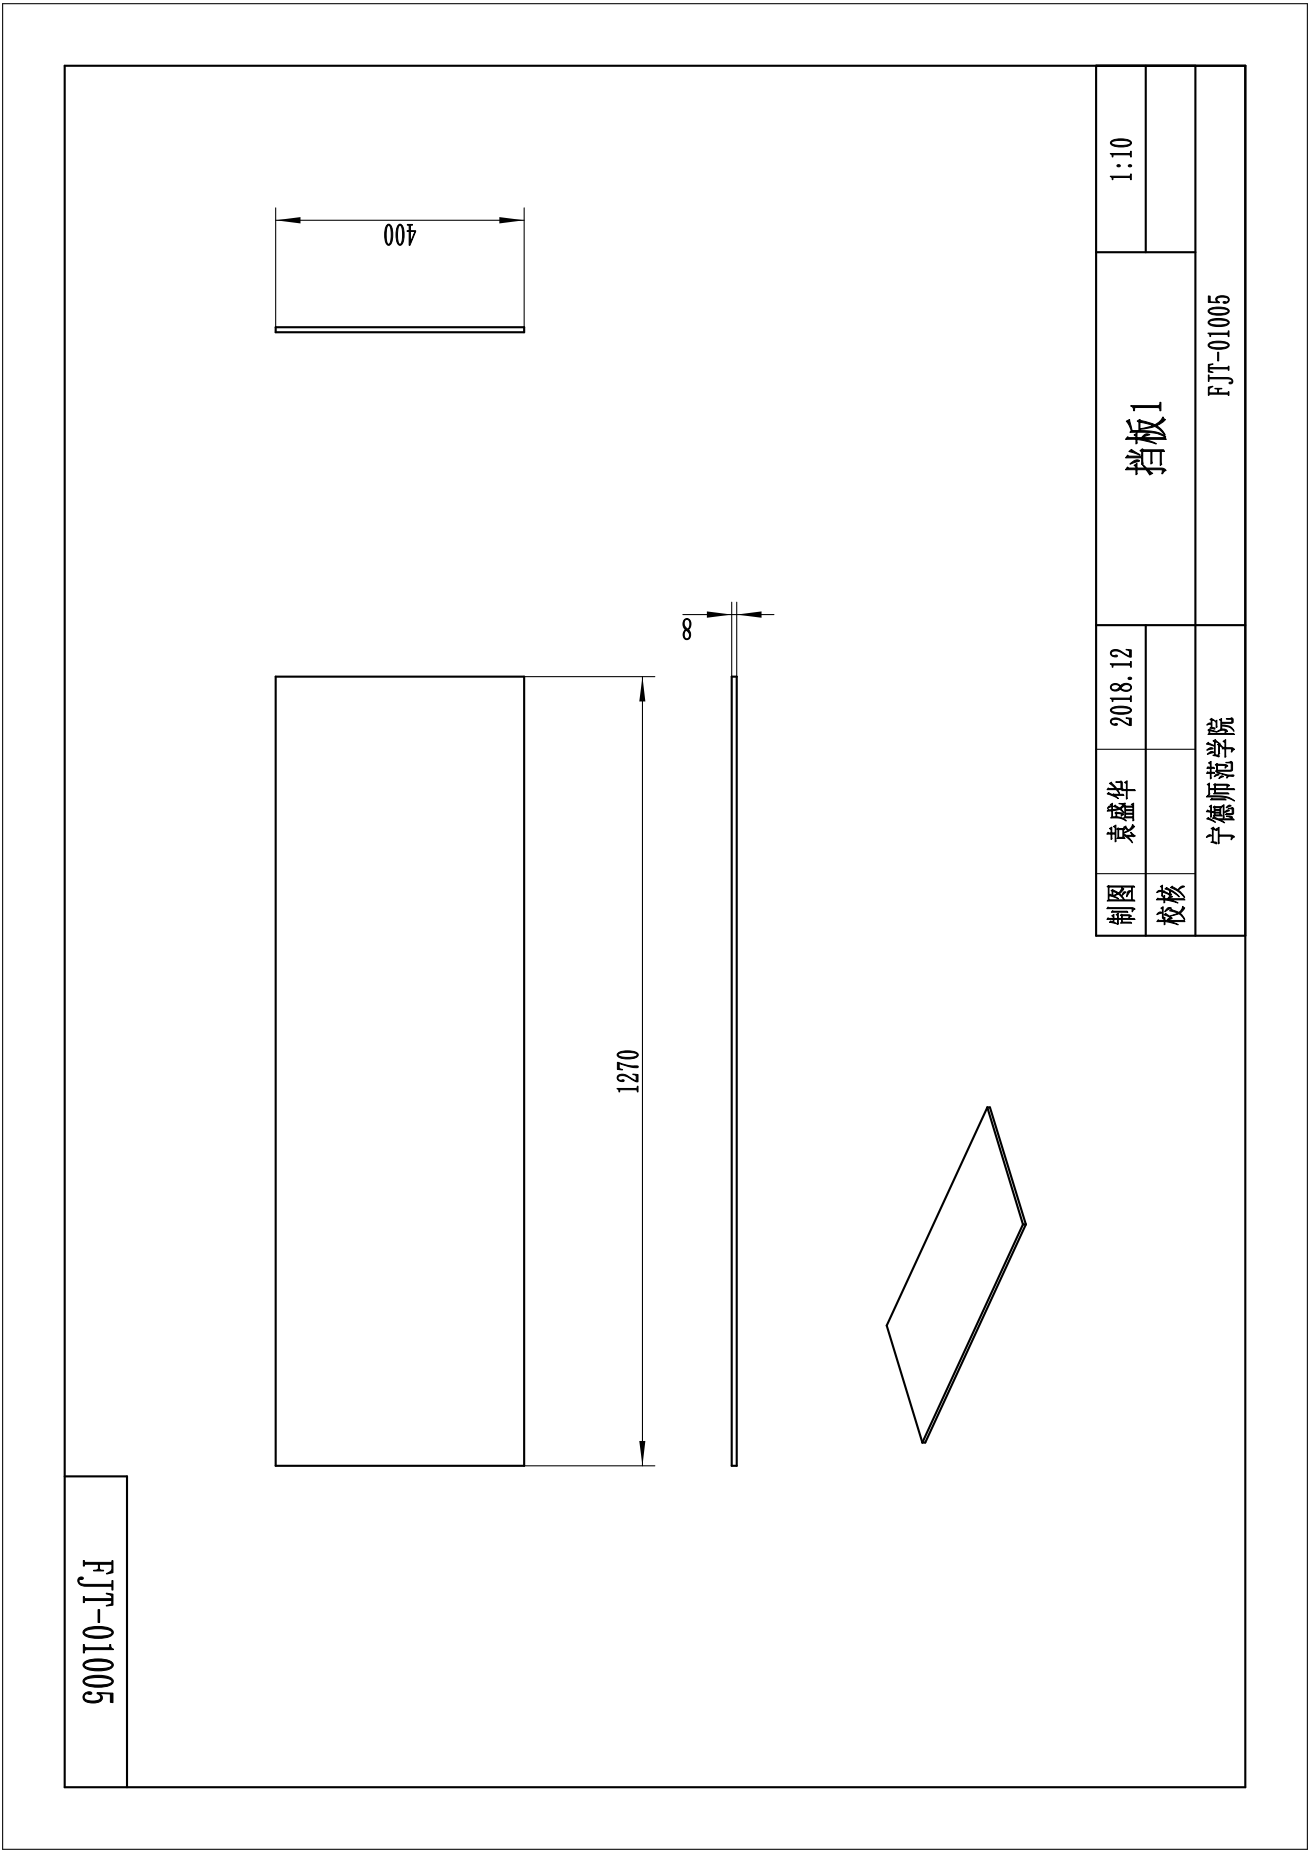
[picture p84: page 1]
