Capful/Graduation_Project/堆肥发酵塔设计/堆肥发酵塔2D图/2D PDF/FJT-01101(支架固定块).pdf

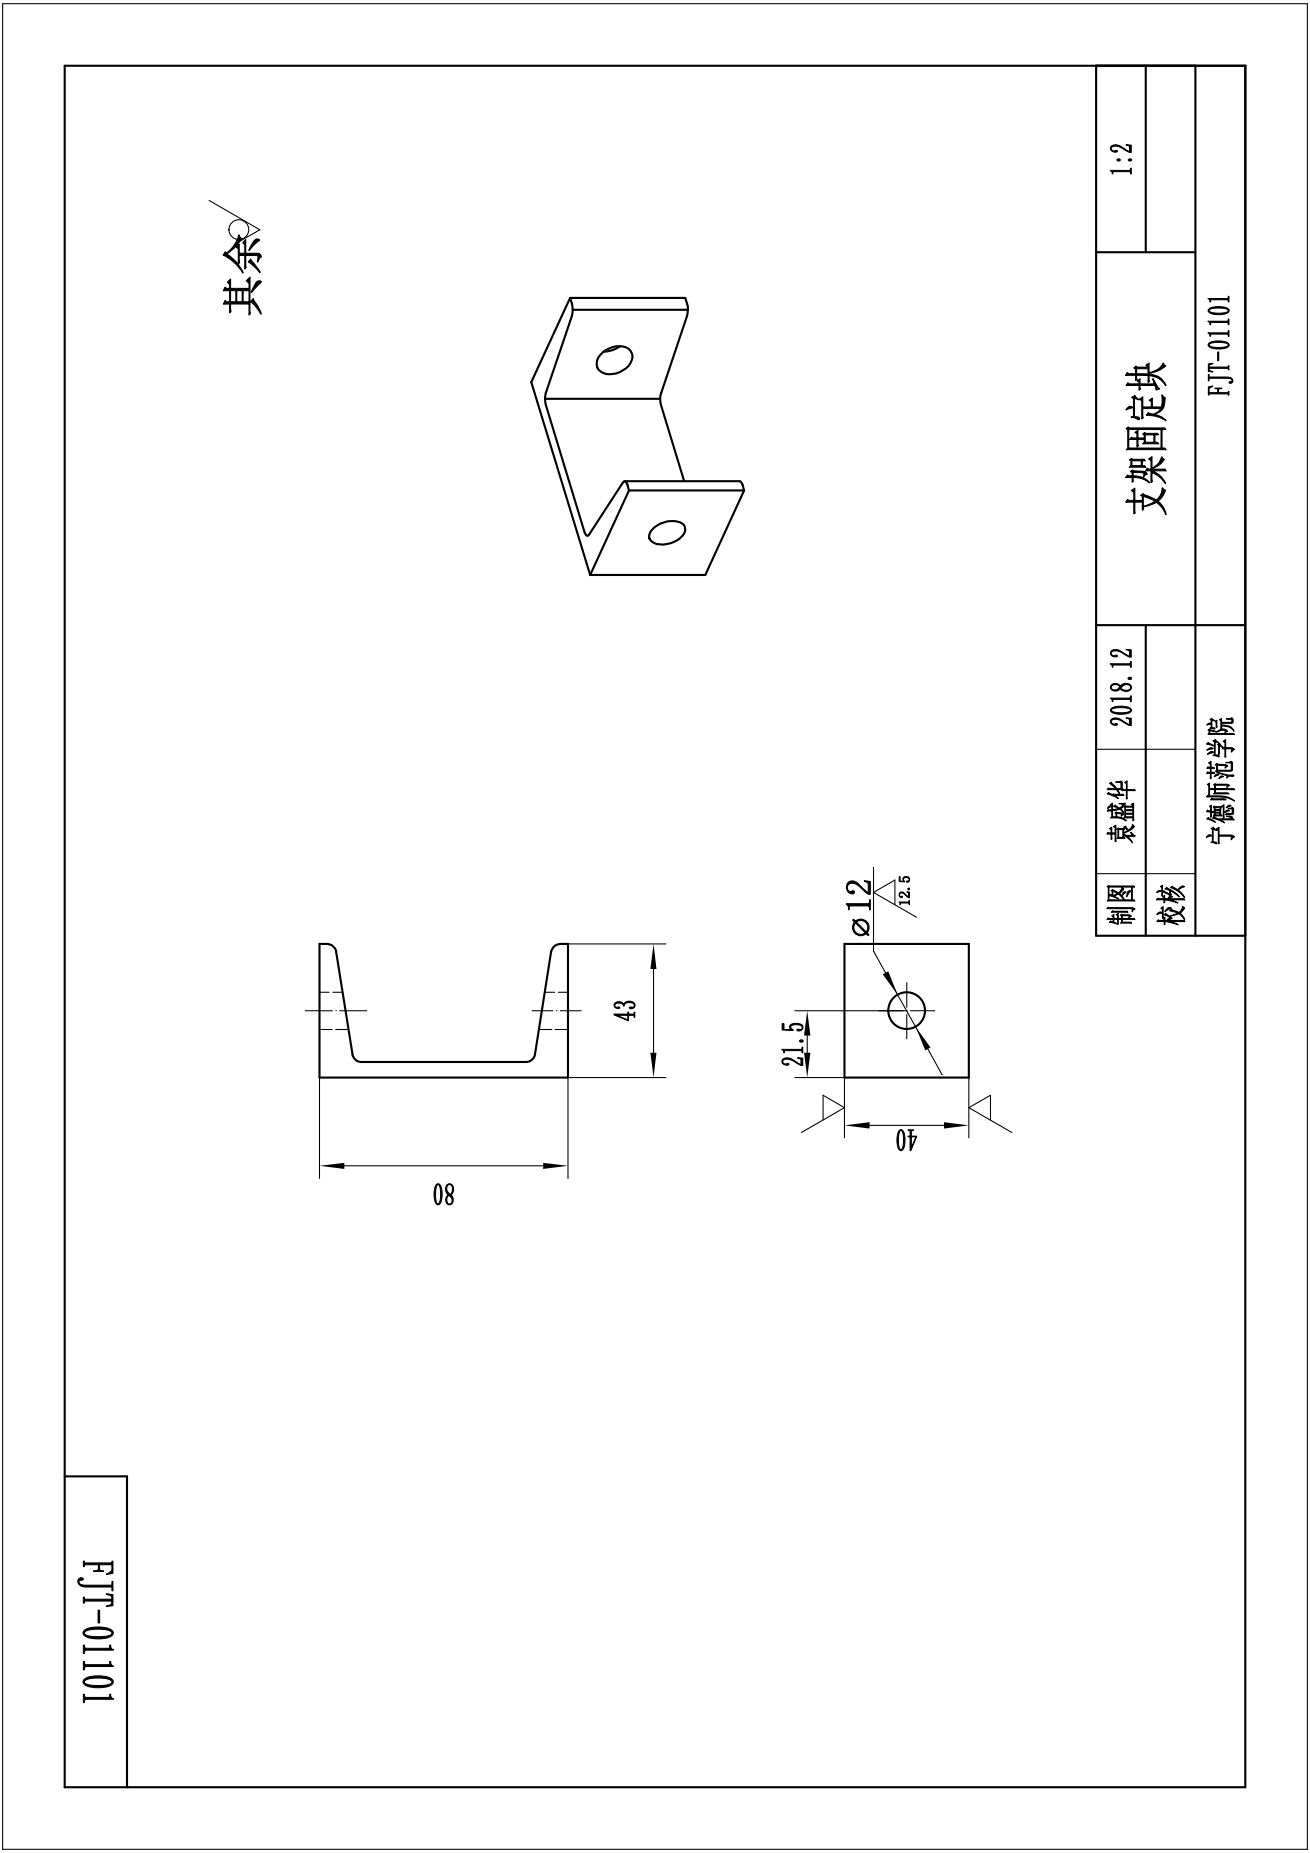
[picture p86: page 1]
