Capful/Graduation_Project/堆肥发酵塔设计/堆肥发酵塔2D图/2D PDF/FJT-01103(挡板固定板2).pdf

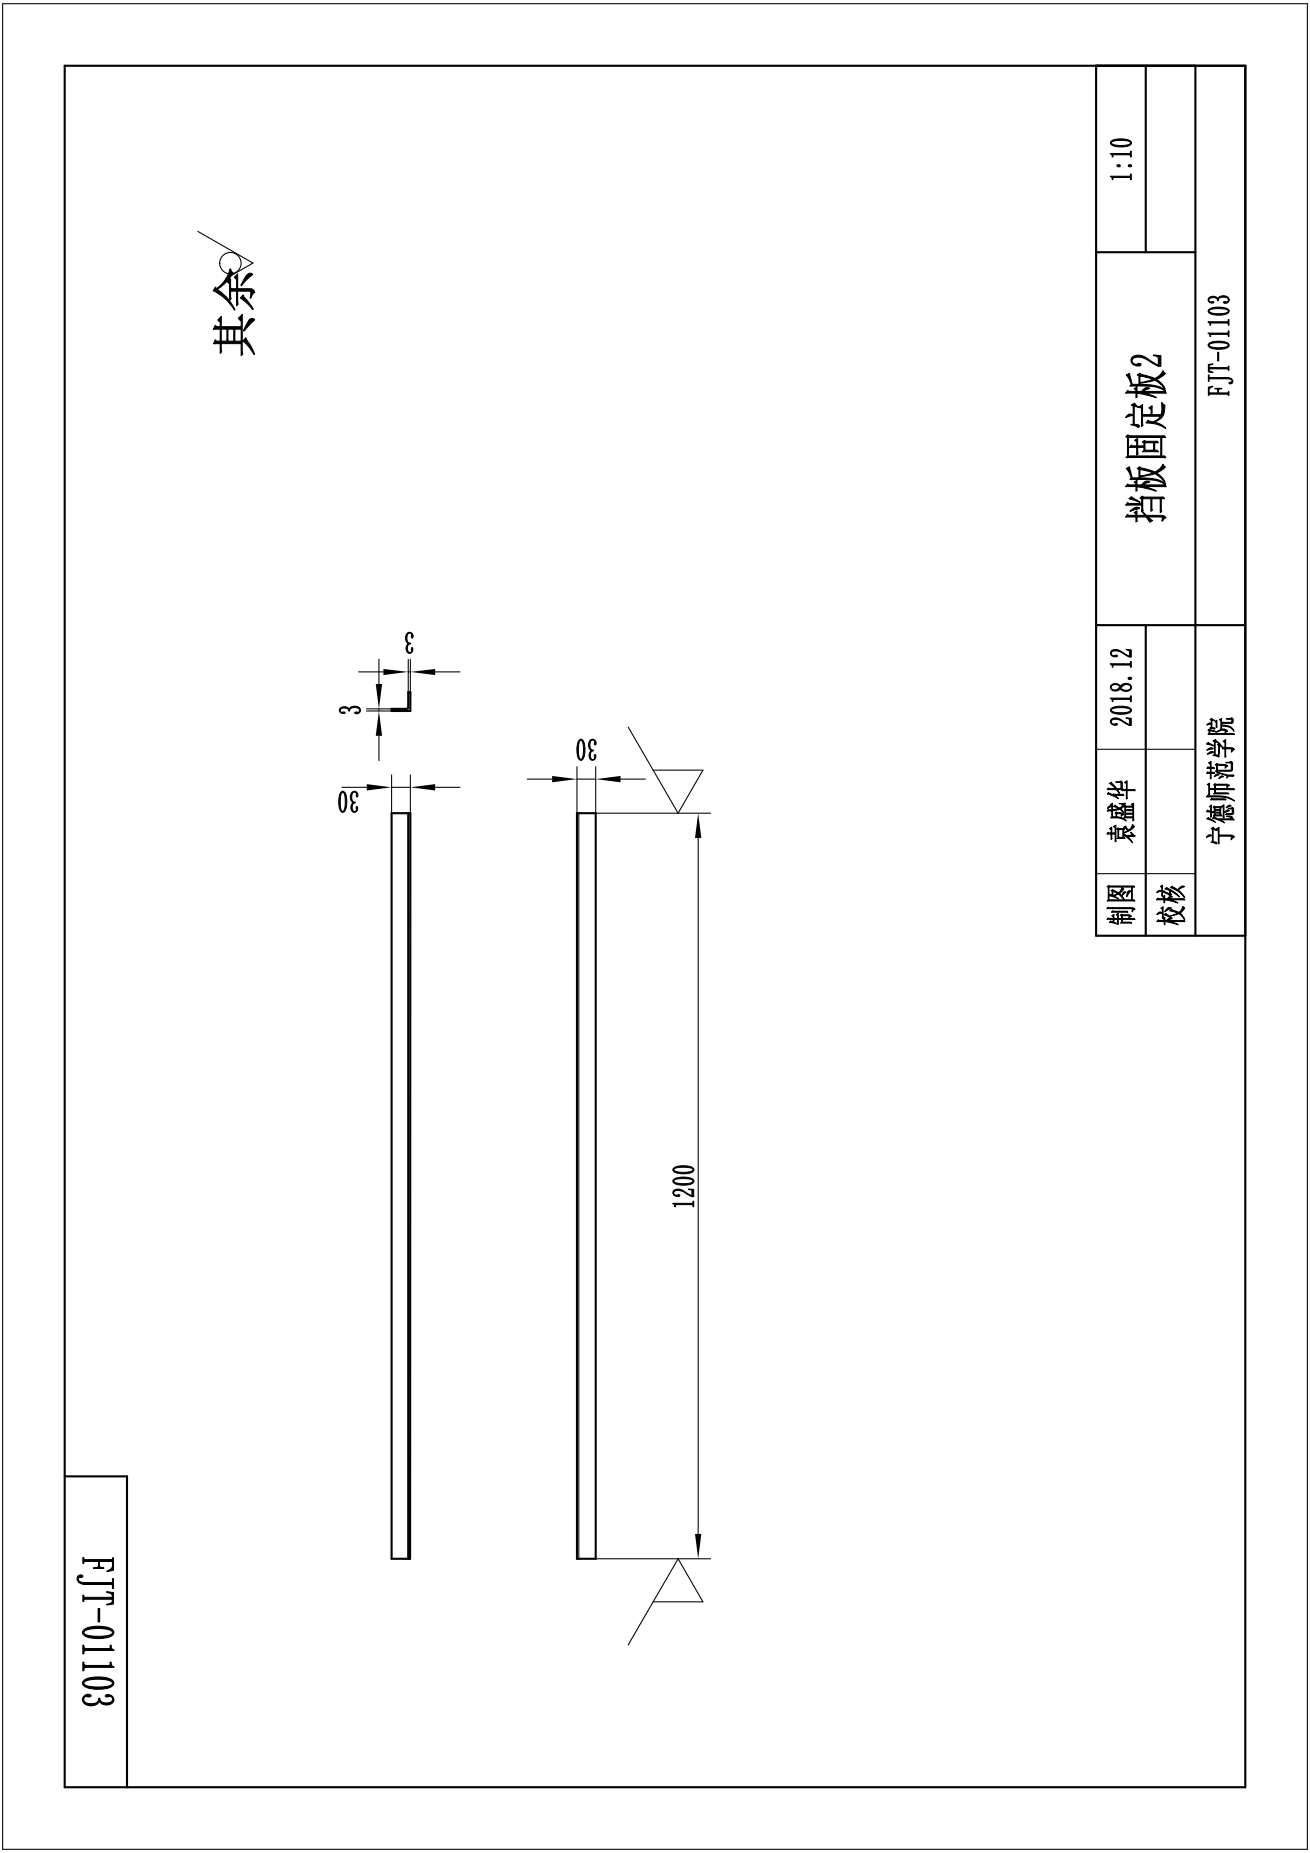
[picture p88: page 1]
