Capful/Graduation_Project/堆肥发酵塔设计/堆肥发酵塔2D图/2D PDF/FJT-01104(垫片).pdf

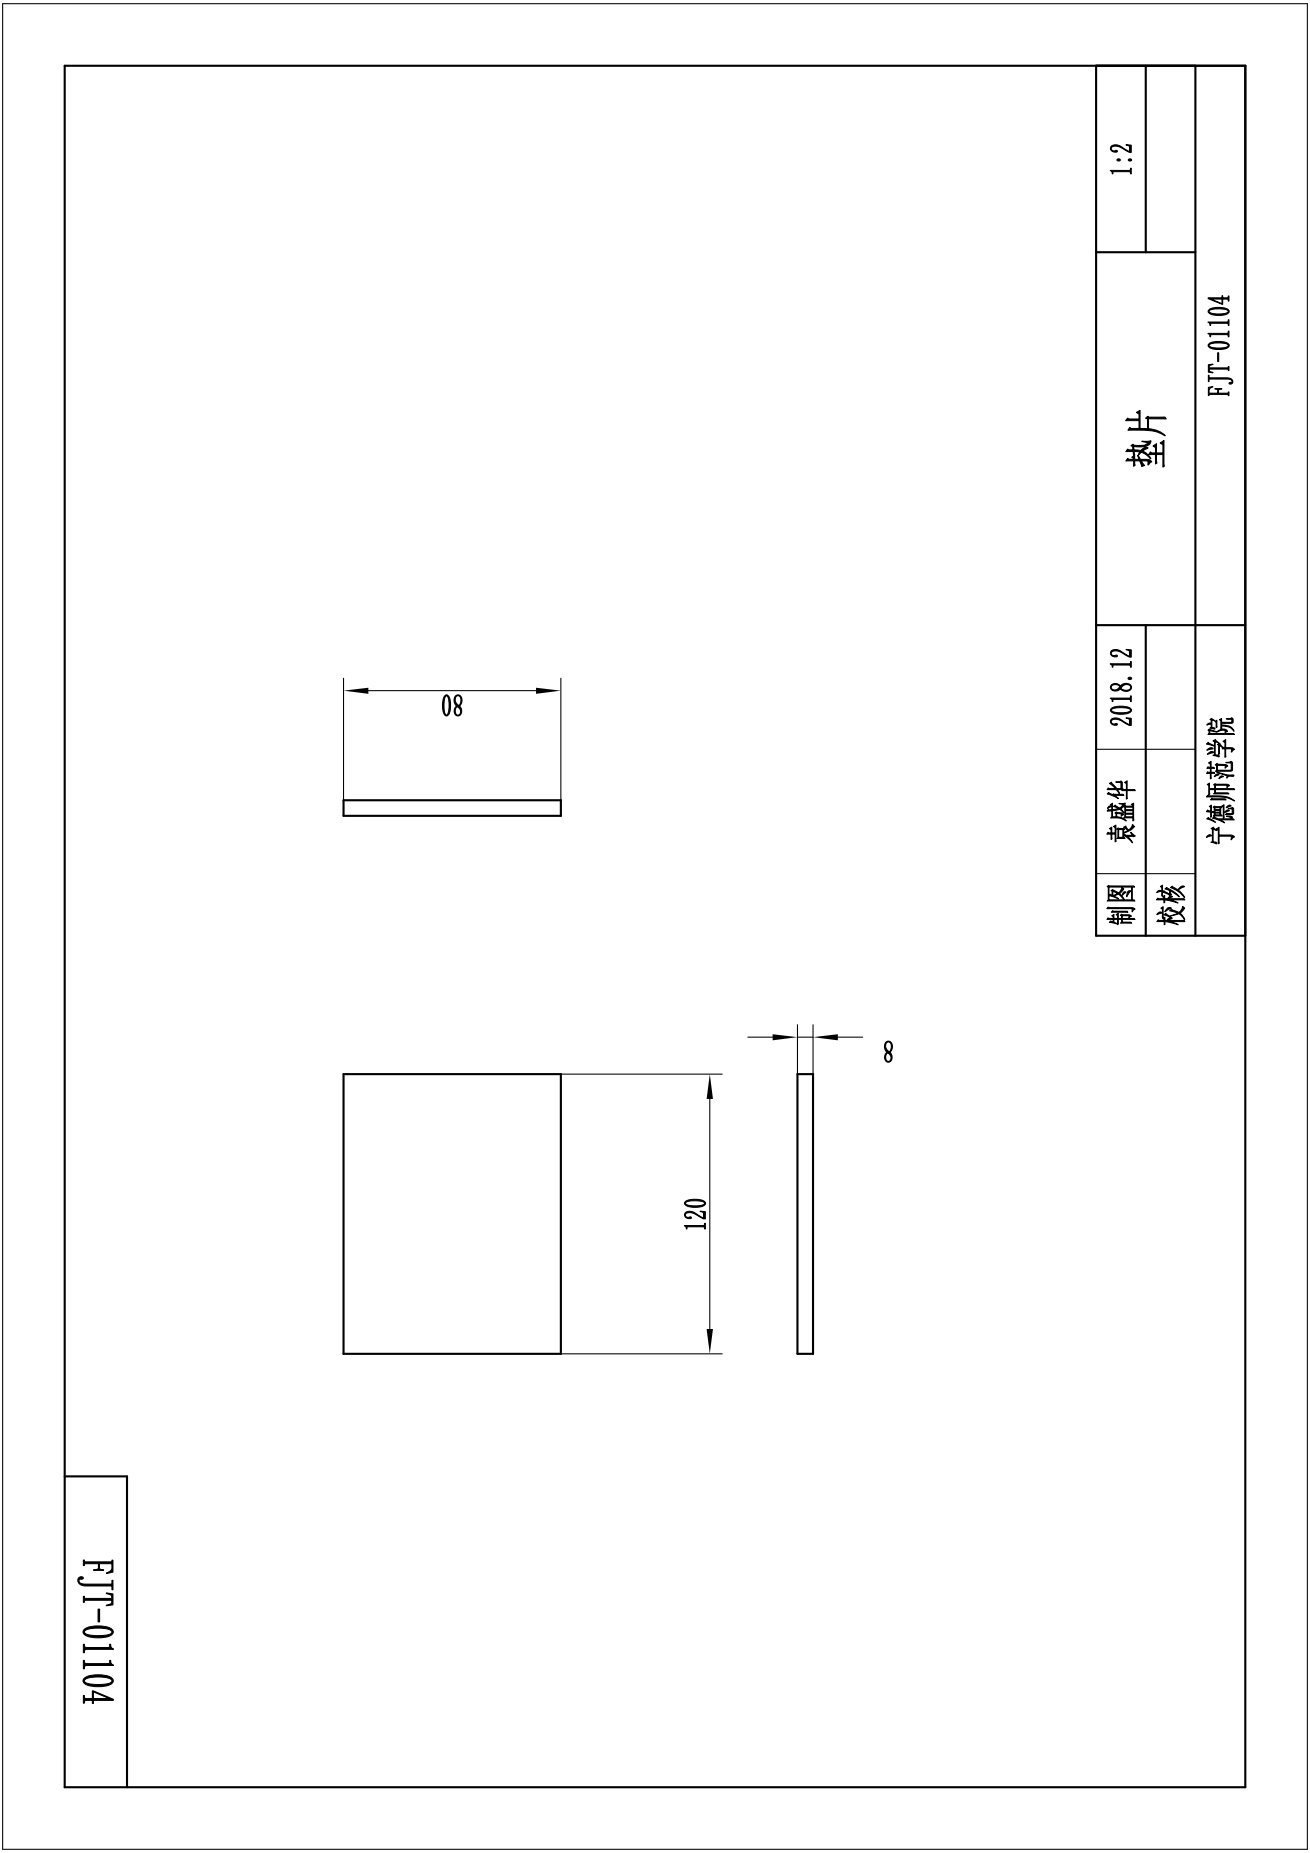
[picture p89: page 1]
