Capful/Graduation_Project/堆肥发酵塔设计/堆肥发酵塔2D图/2D PDF/FJT-01200(左支架).pdf

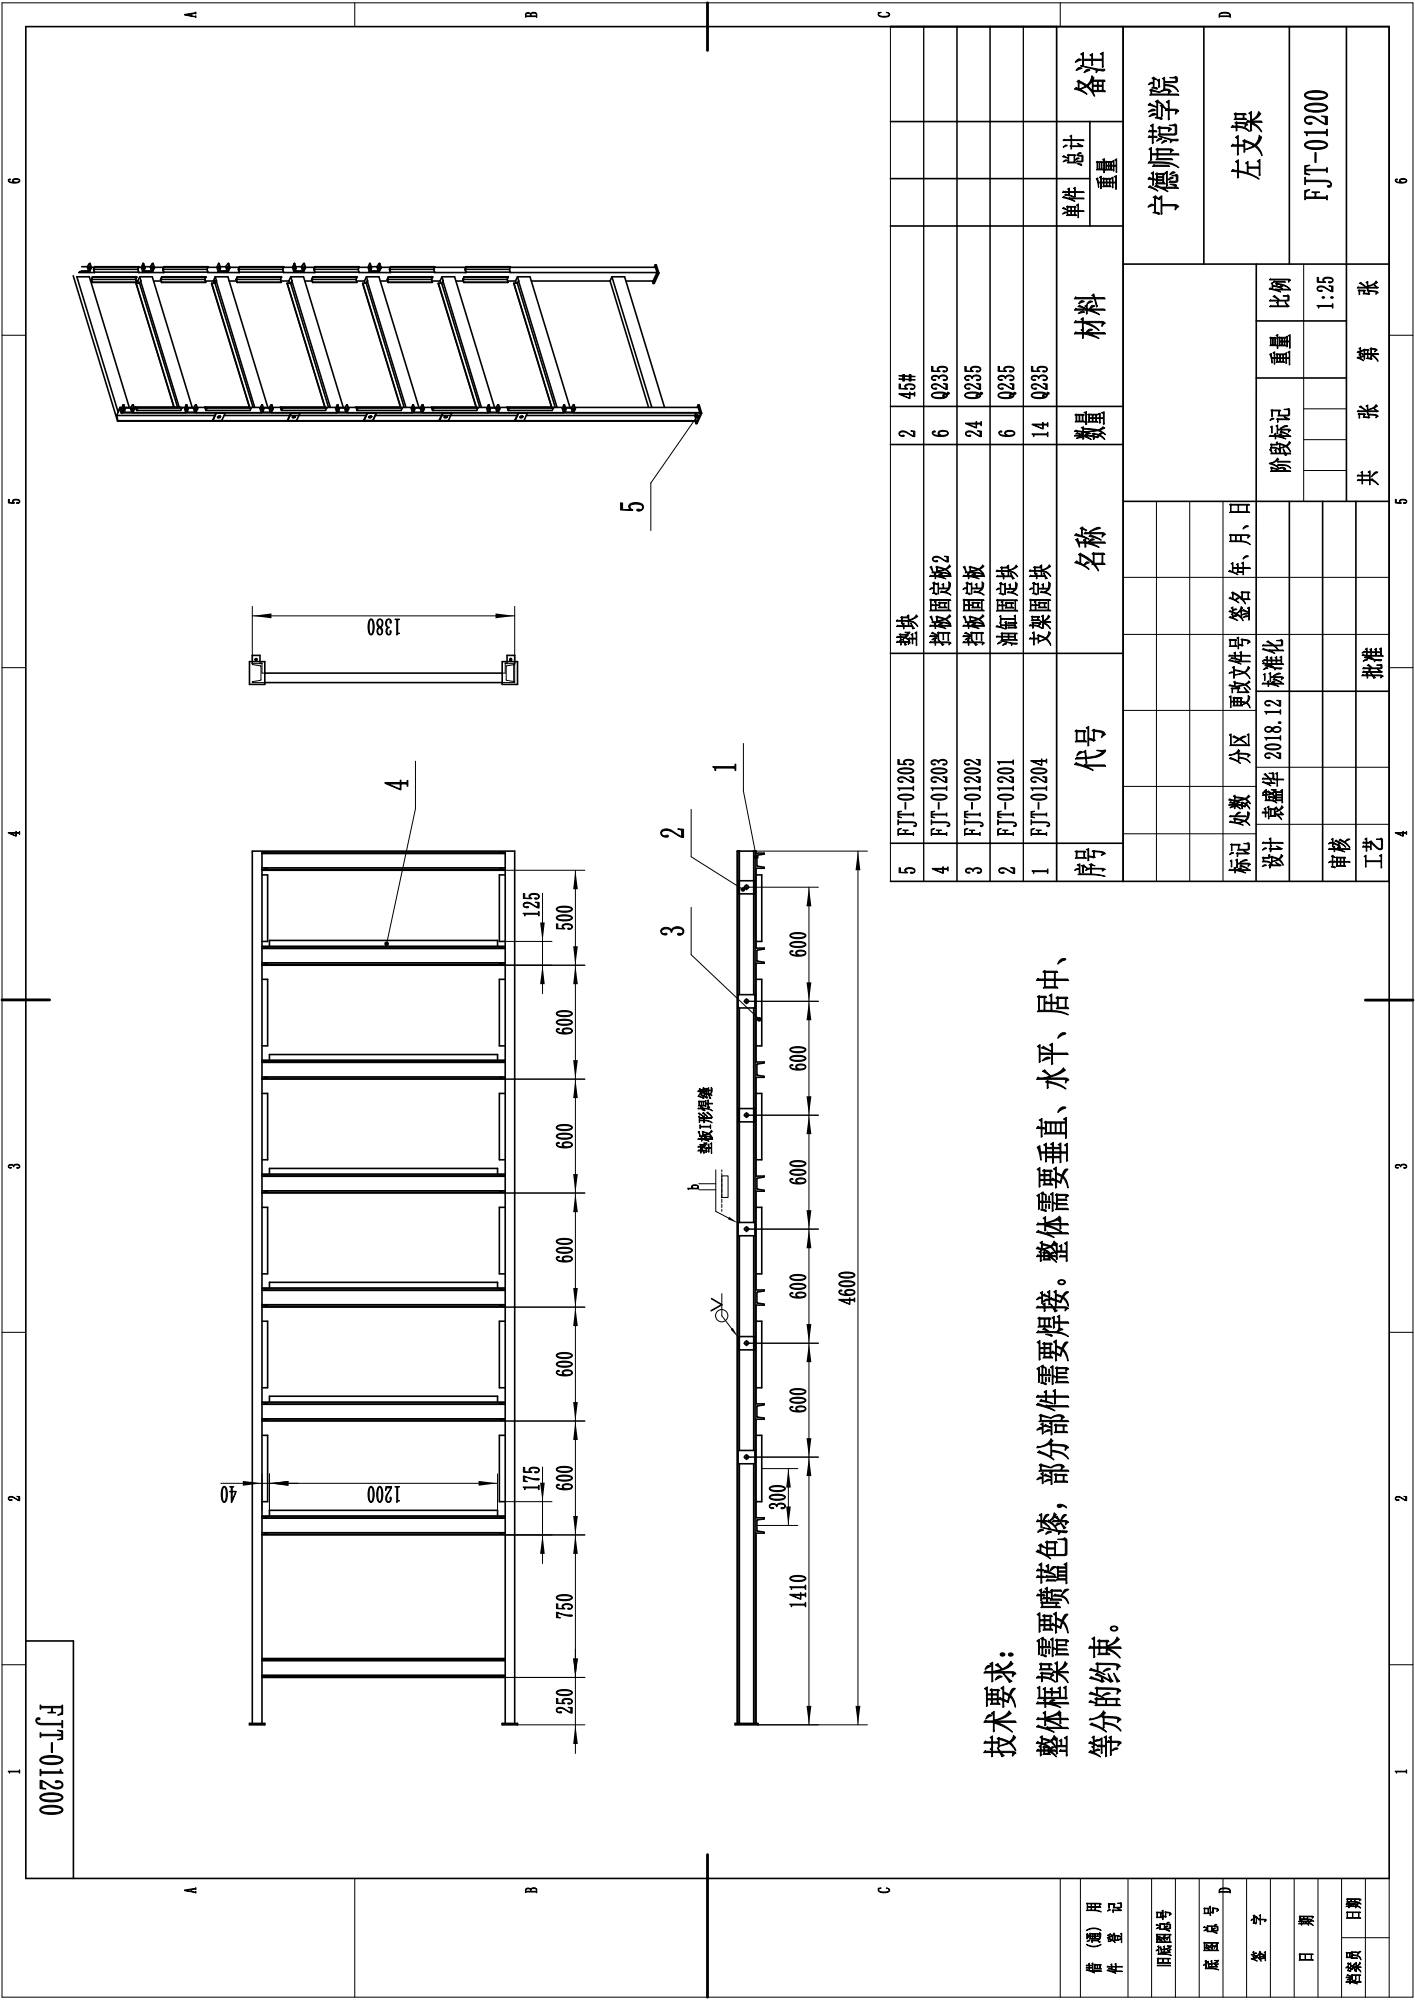
[picture p90: page 1]
