Capful/Graduation_Project/堆肥发酵塔设计/堆肥发酵塔2D图/2D PDF/FJT-01202(挡板固定板).pdf

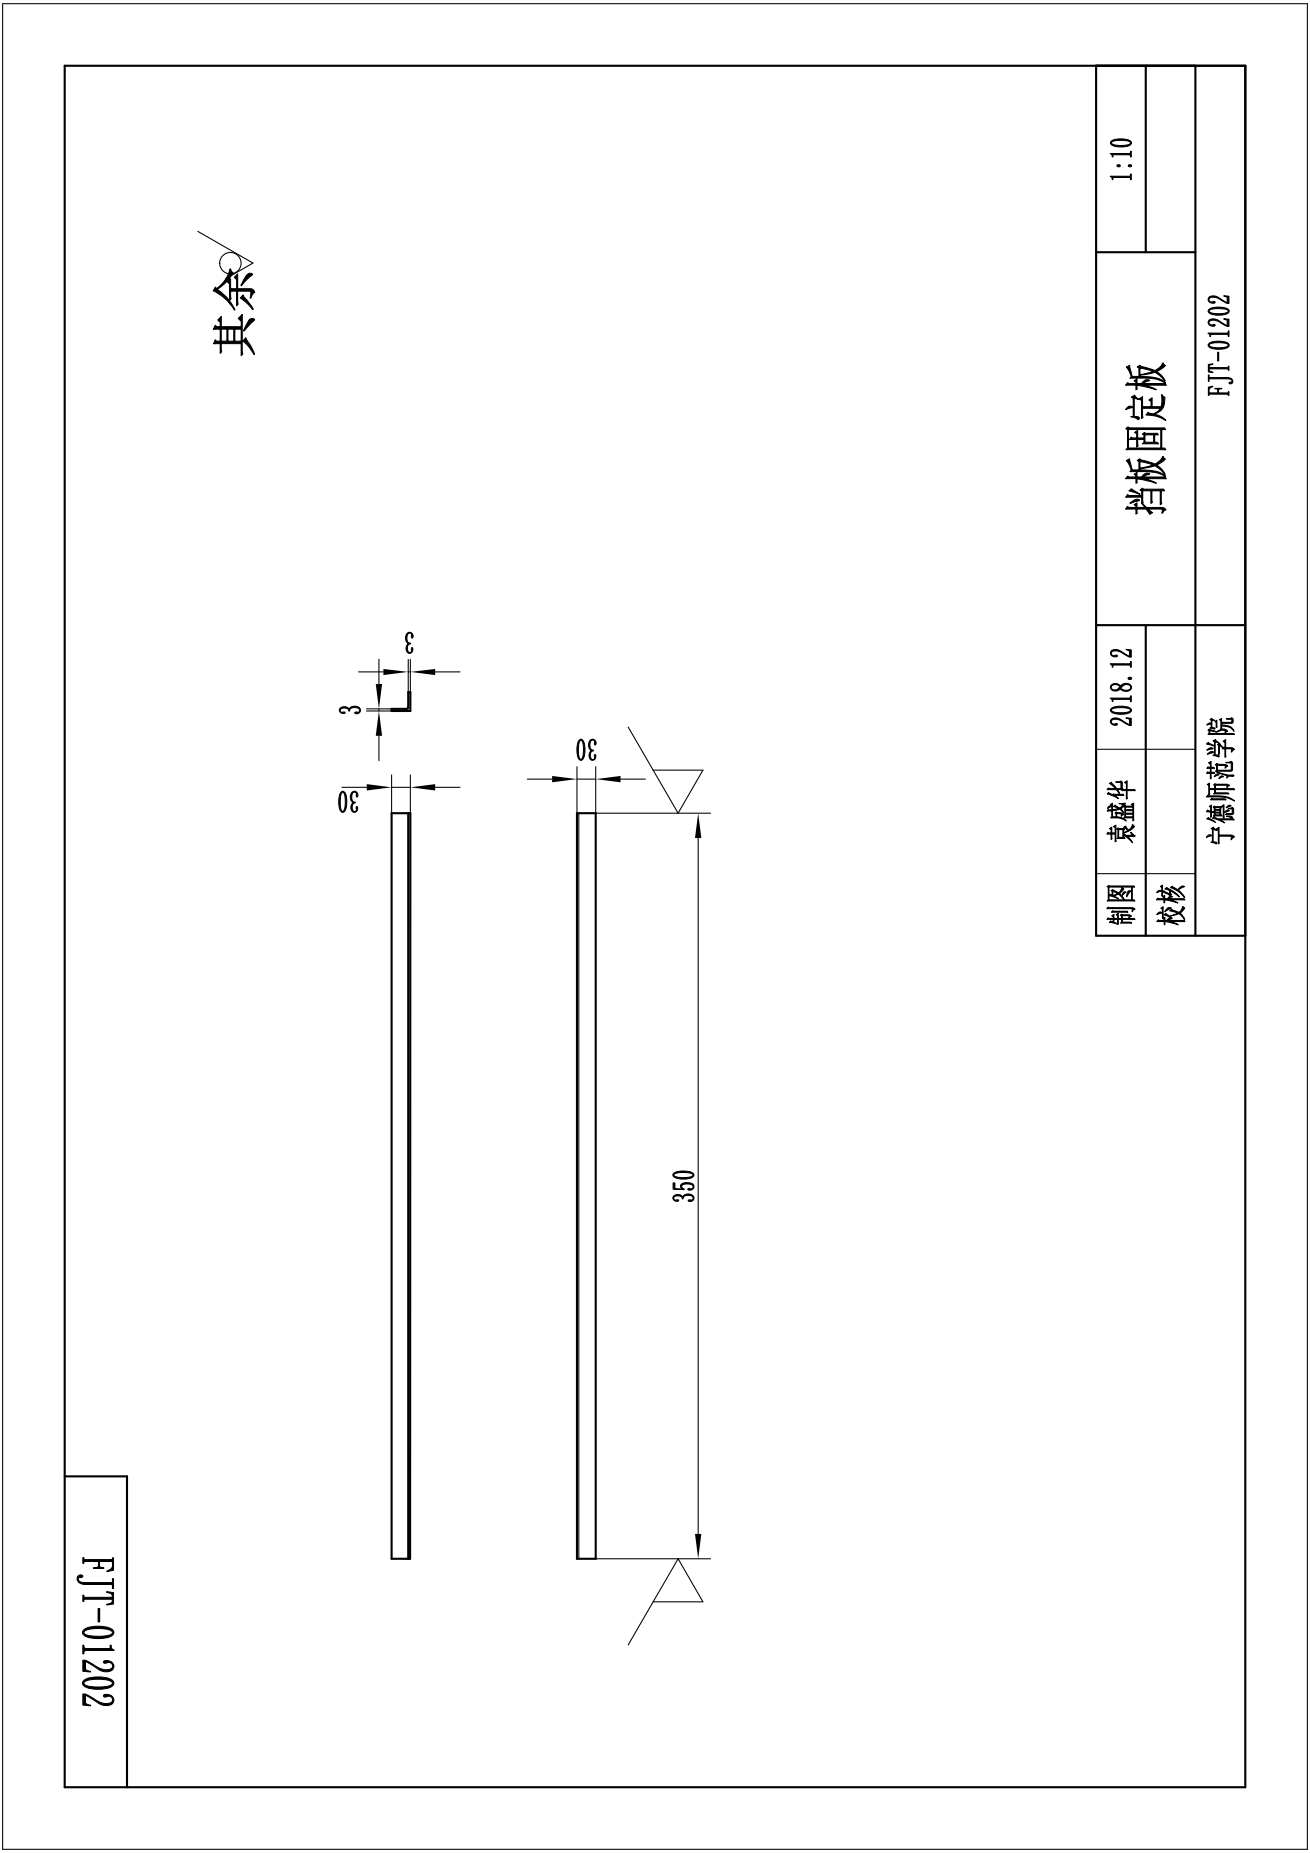
[picture p91: page 1]
