Capful/Graduation_Project/堆肥发酵塔设计/堆肥发酵塔2D图/2D PDF/FJT-01203(挡板固定板2).pdf

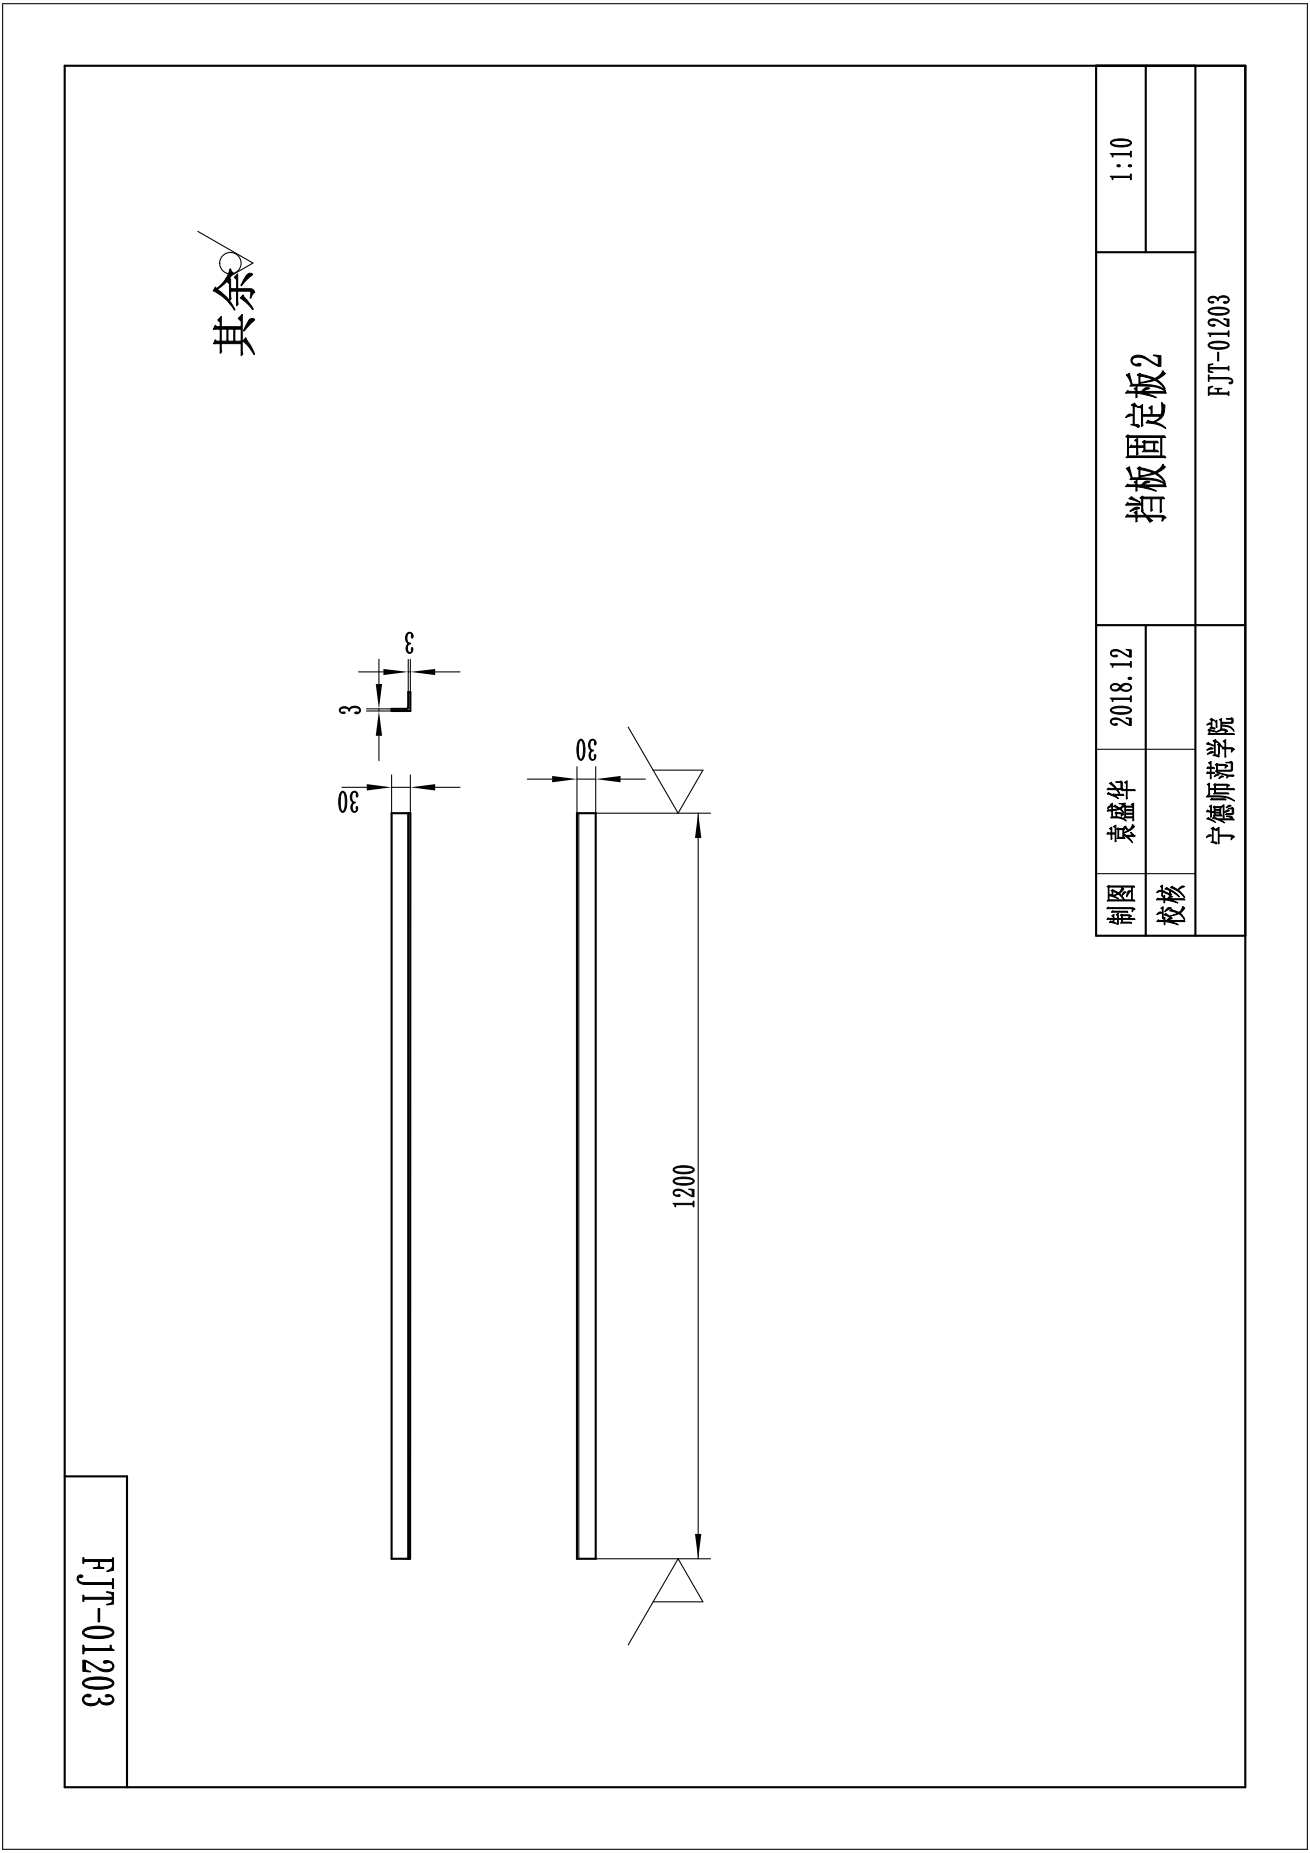
[picture p92: page 1]
