Capful/Graduation_Project/堆肥发酵塔设计/堆肥发酵塔2D图/2D PDF/FJT-01205(垫片).pdf

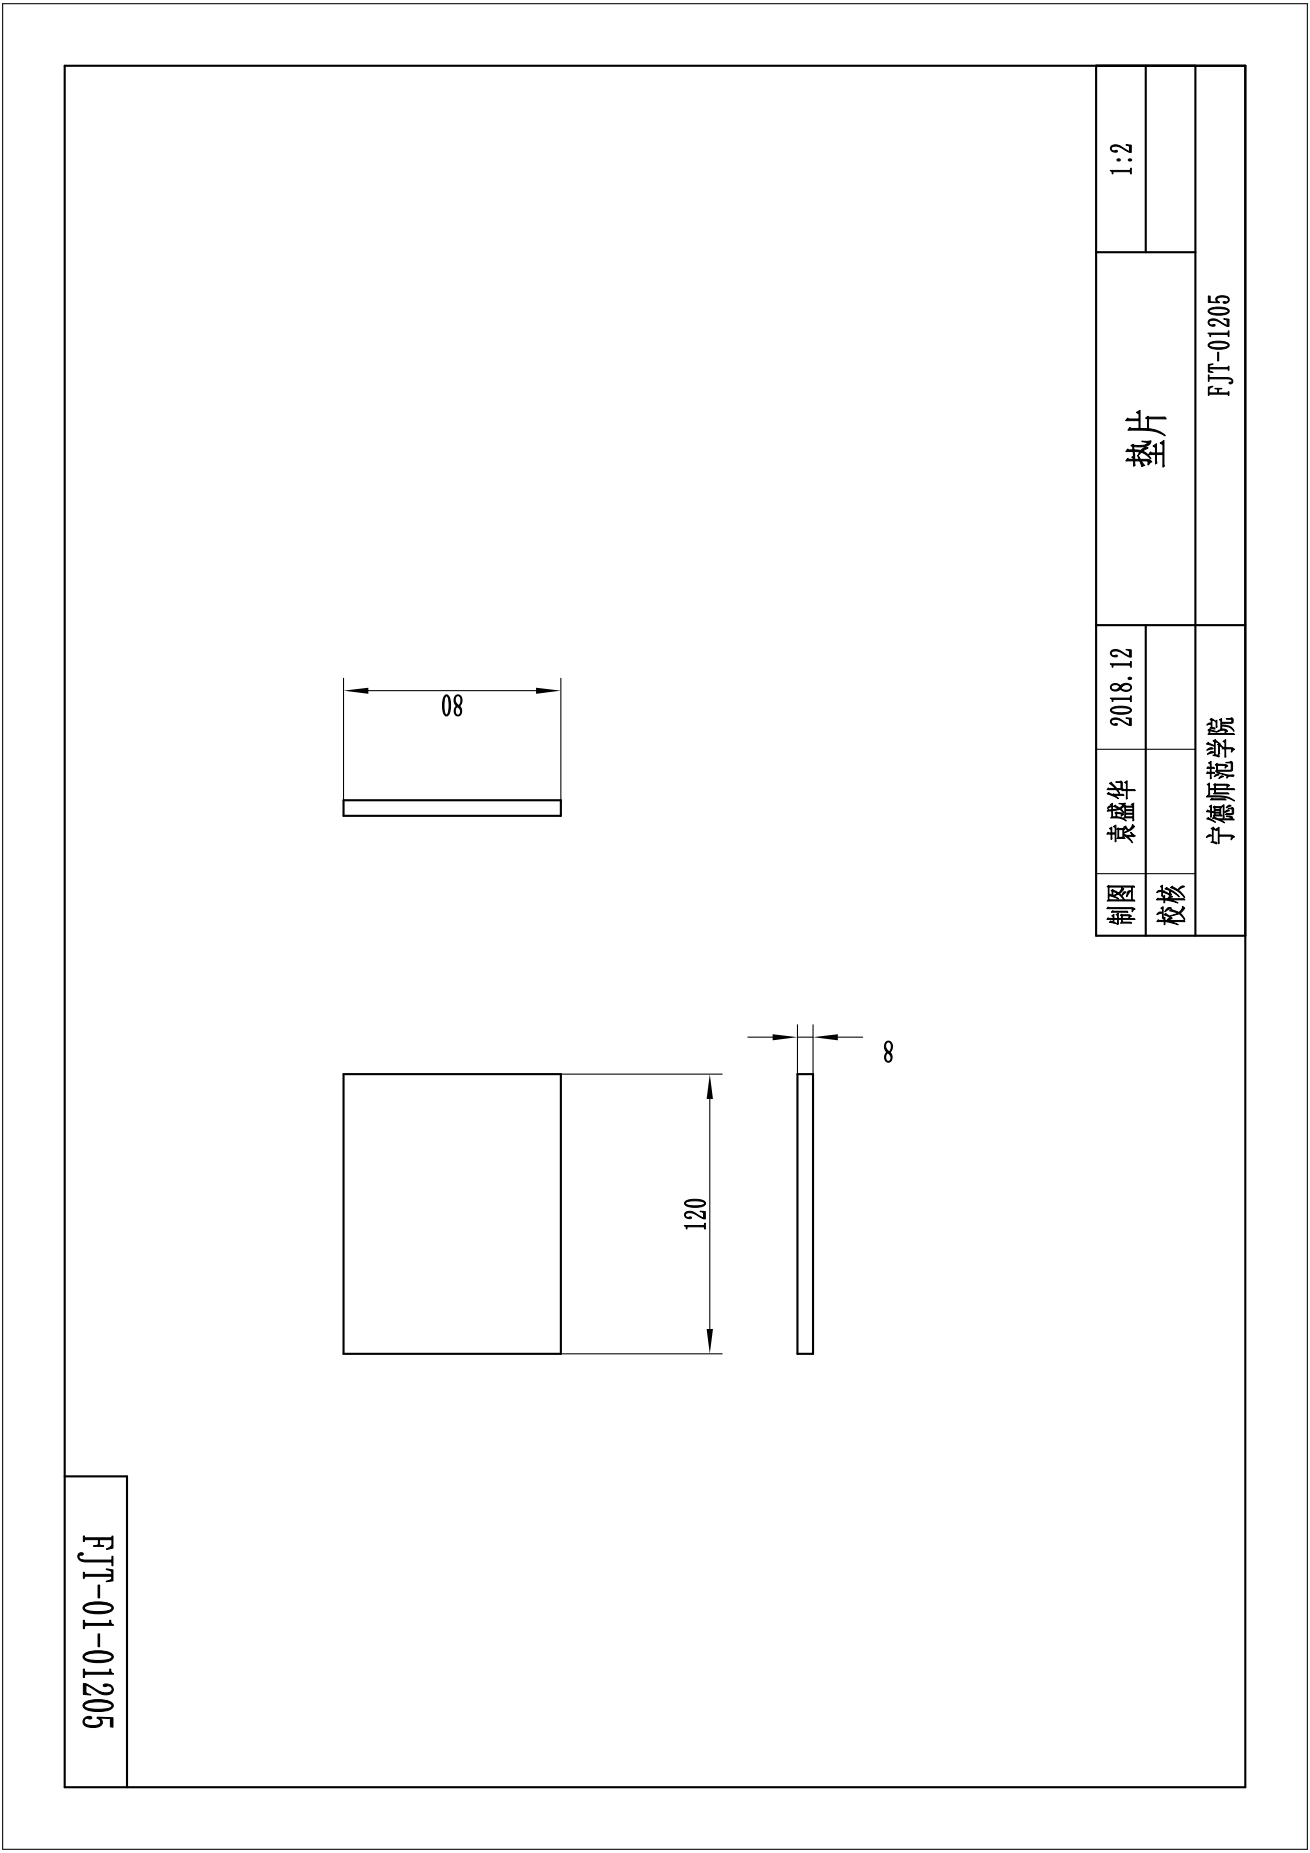
[picture p93: page 1]
