Capful/Graduation_Project/堆肥发酵塔设计/堆肥发酵塔2D图/2D PDF/FJT-01301(角铁).pdf

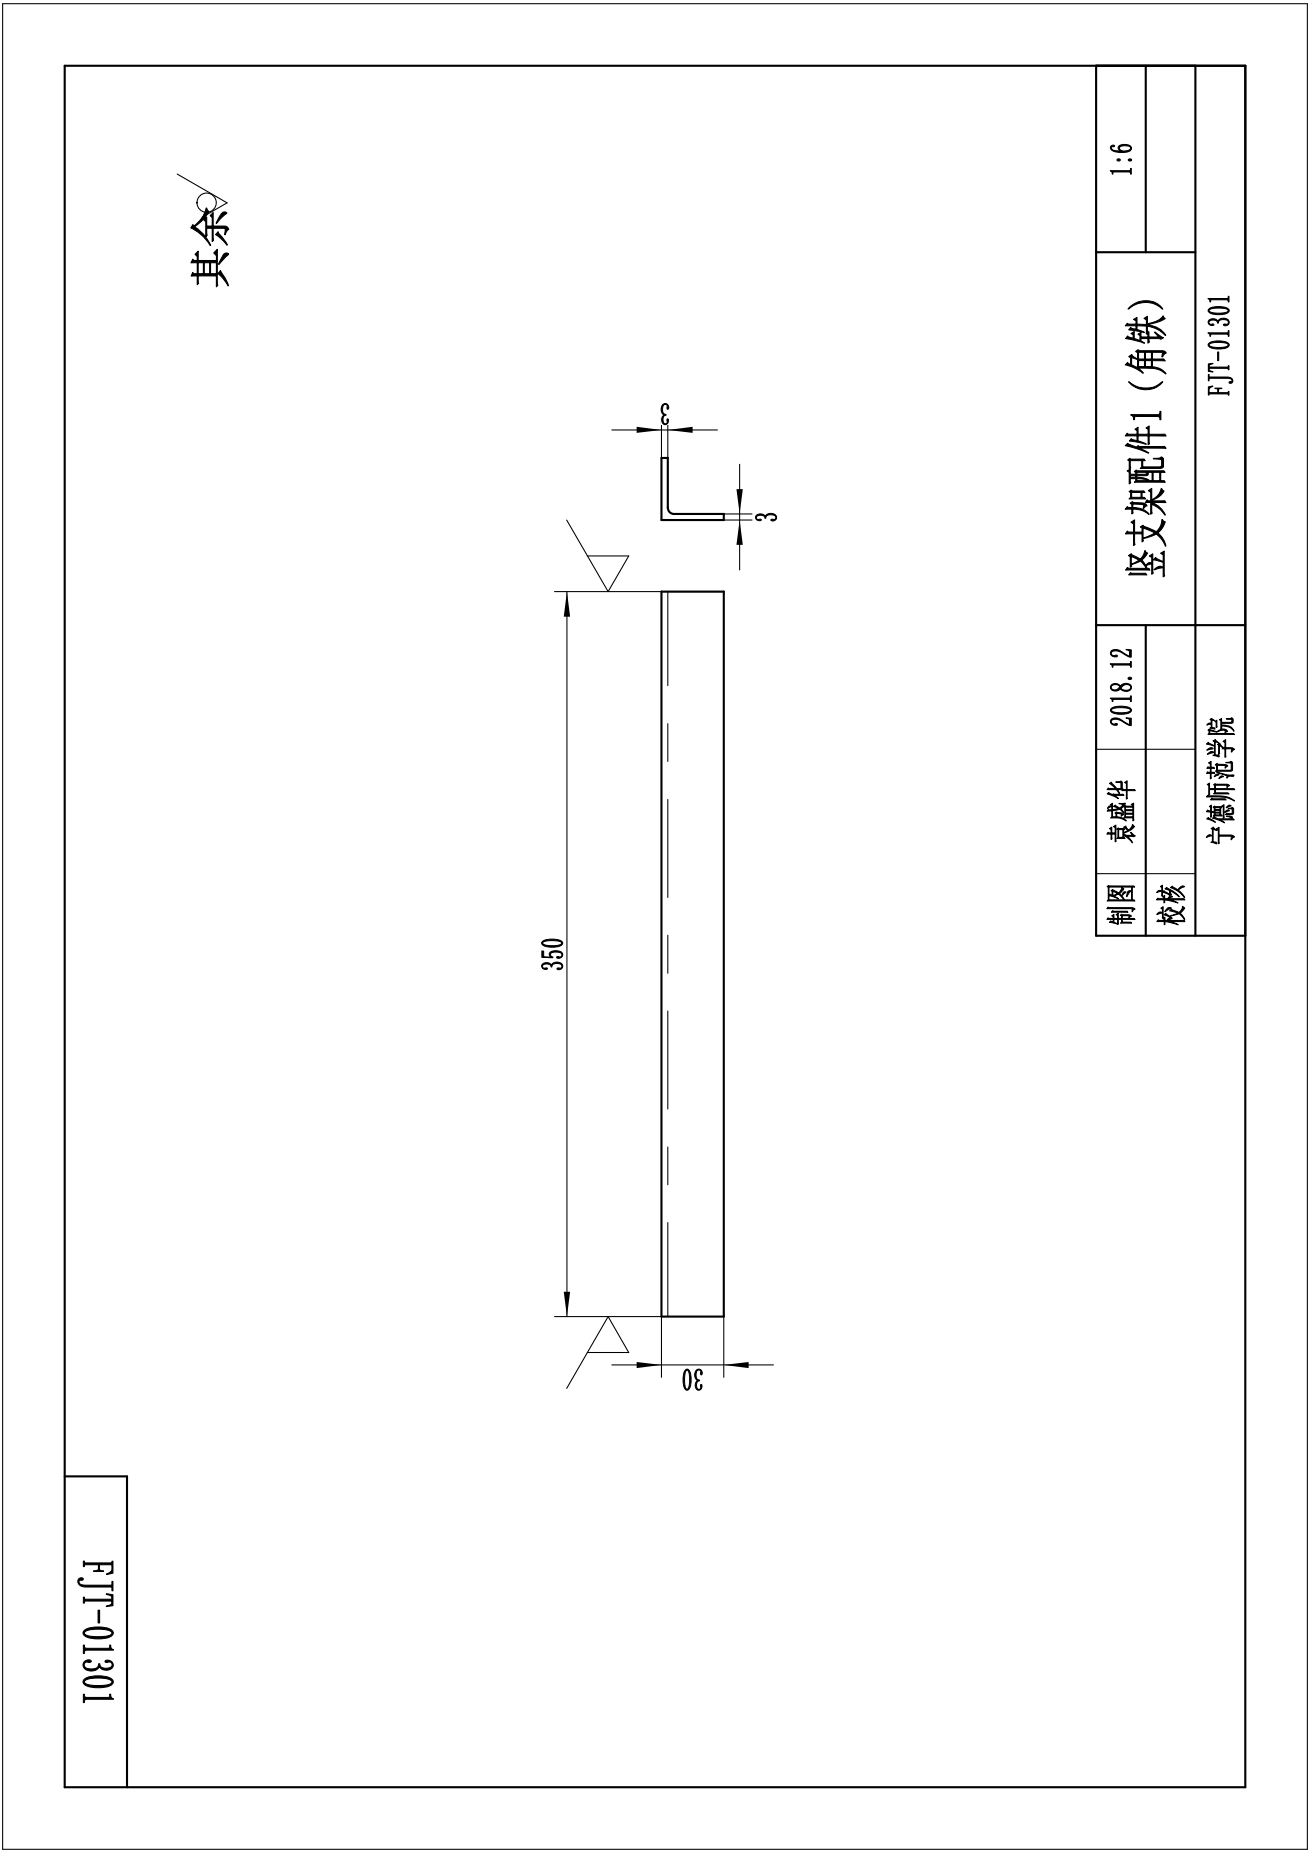
[picture p94: page 1]
