Capful/Graduation_Project/堆肥发酵塔设计/堆肥发酵塔2D图/2D PDF/FJT-01302(槽钢).pdf

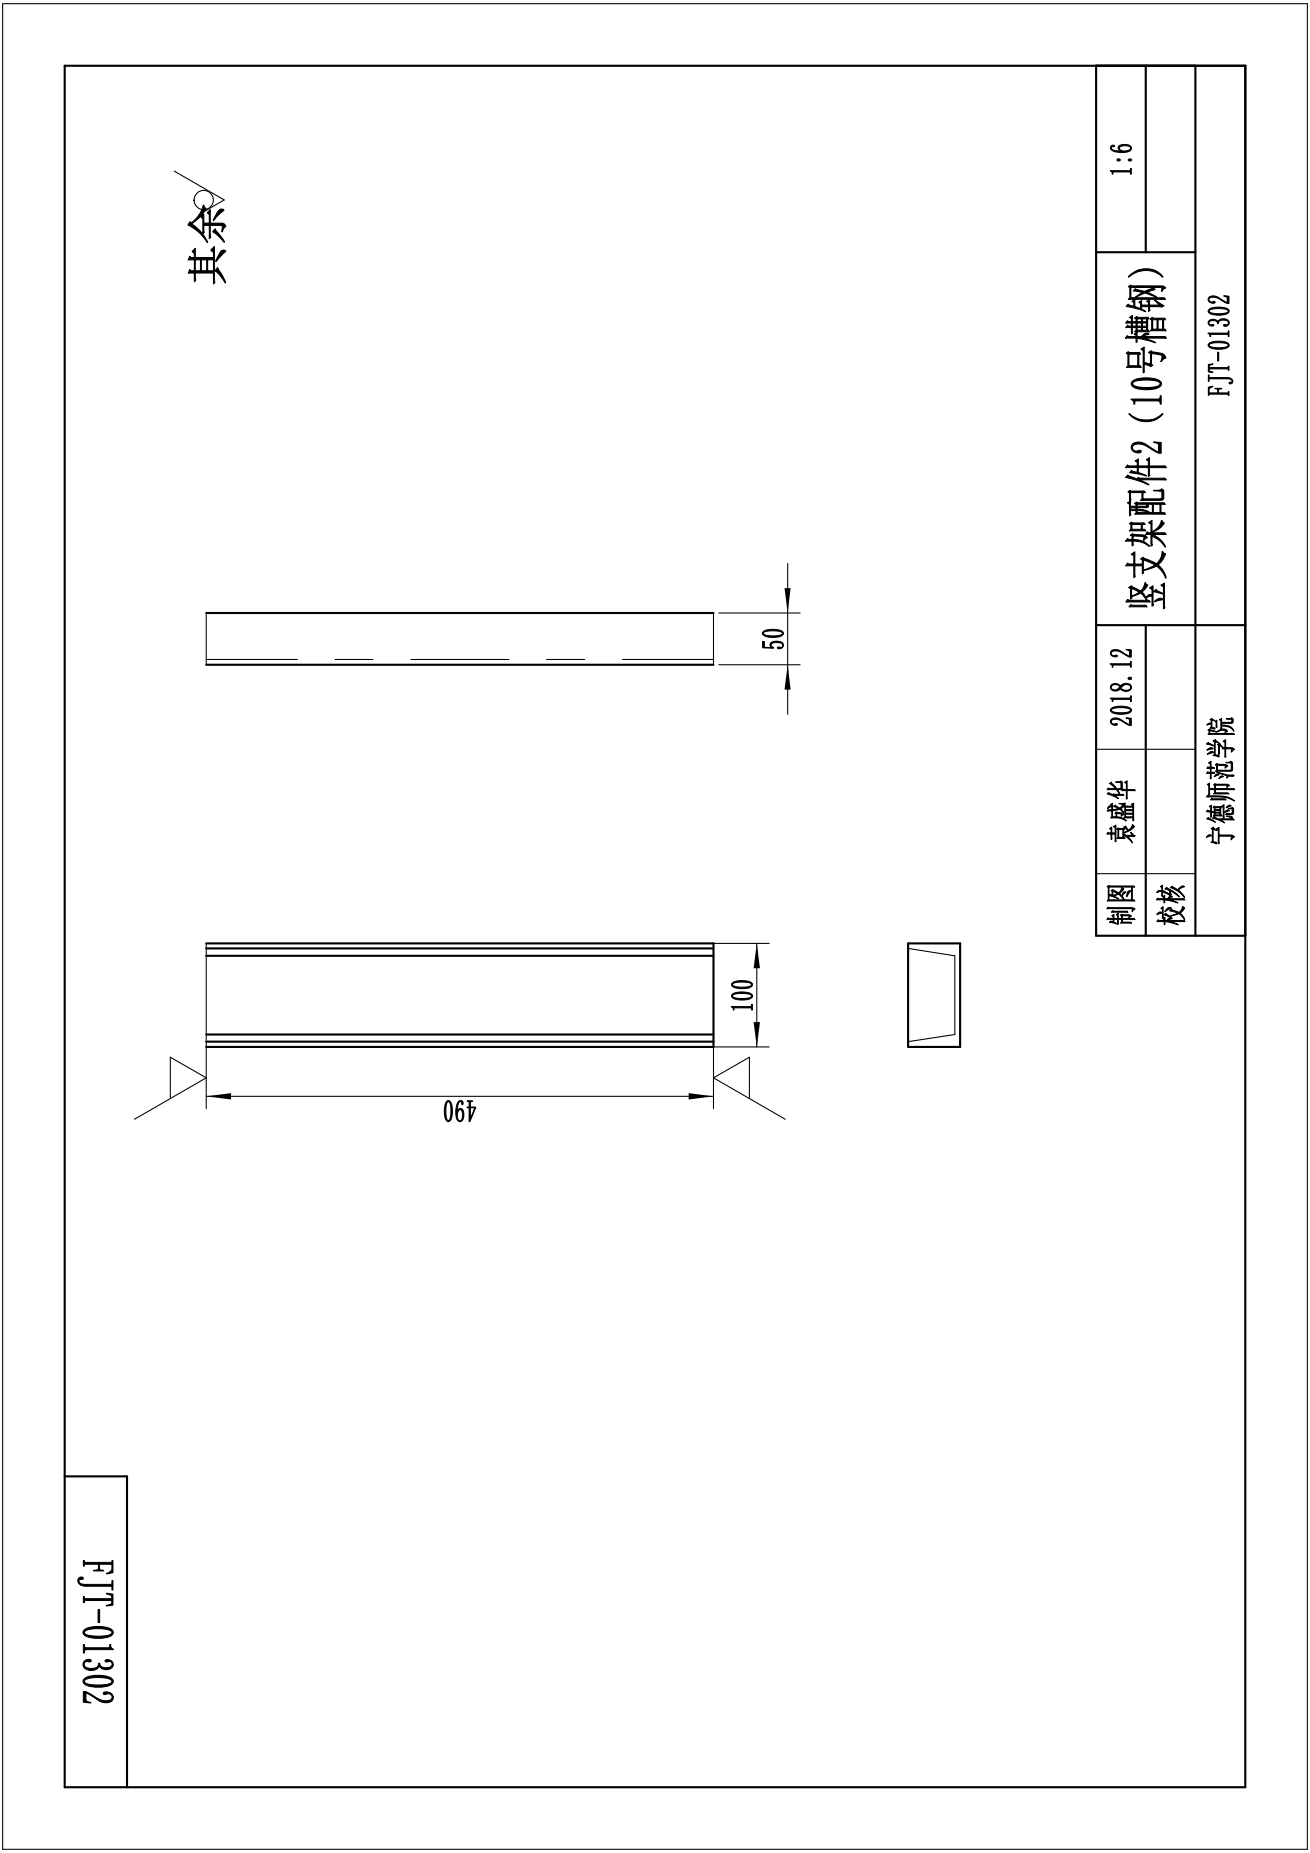
[picture p95: page 1]
