Capful/Graduation_Project/堆肥发酵塔设计/堆肥发酵塔2D图/2D PDF/FJT-01303(钢板).pdf

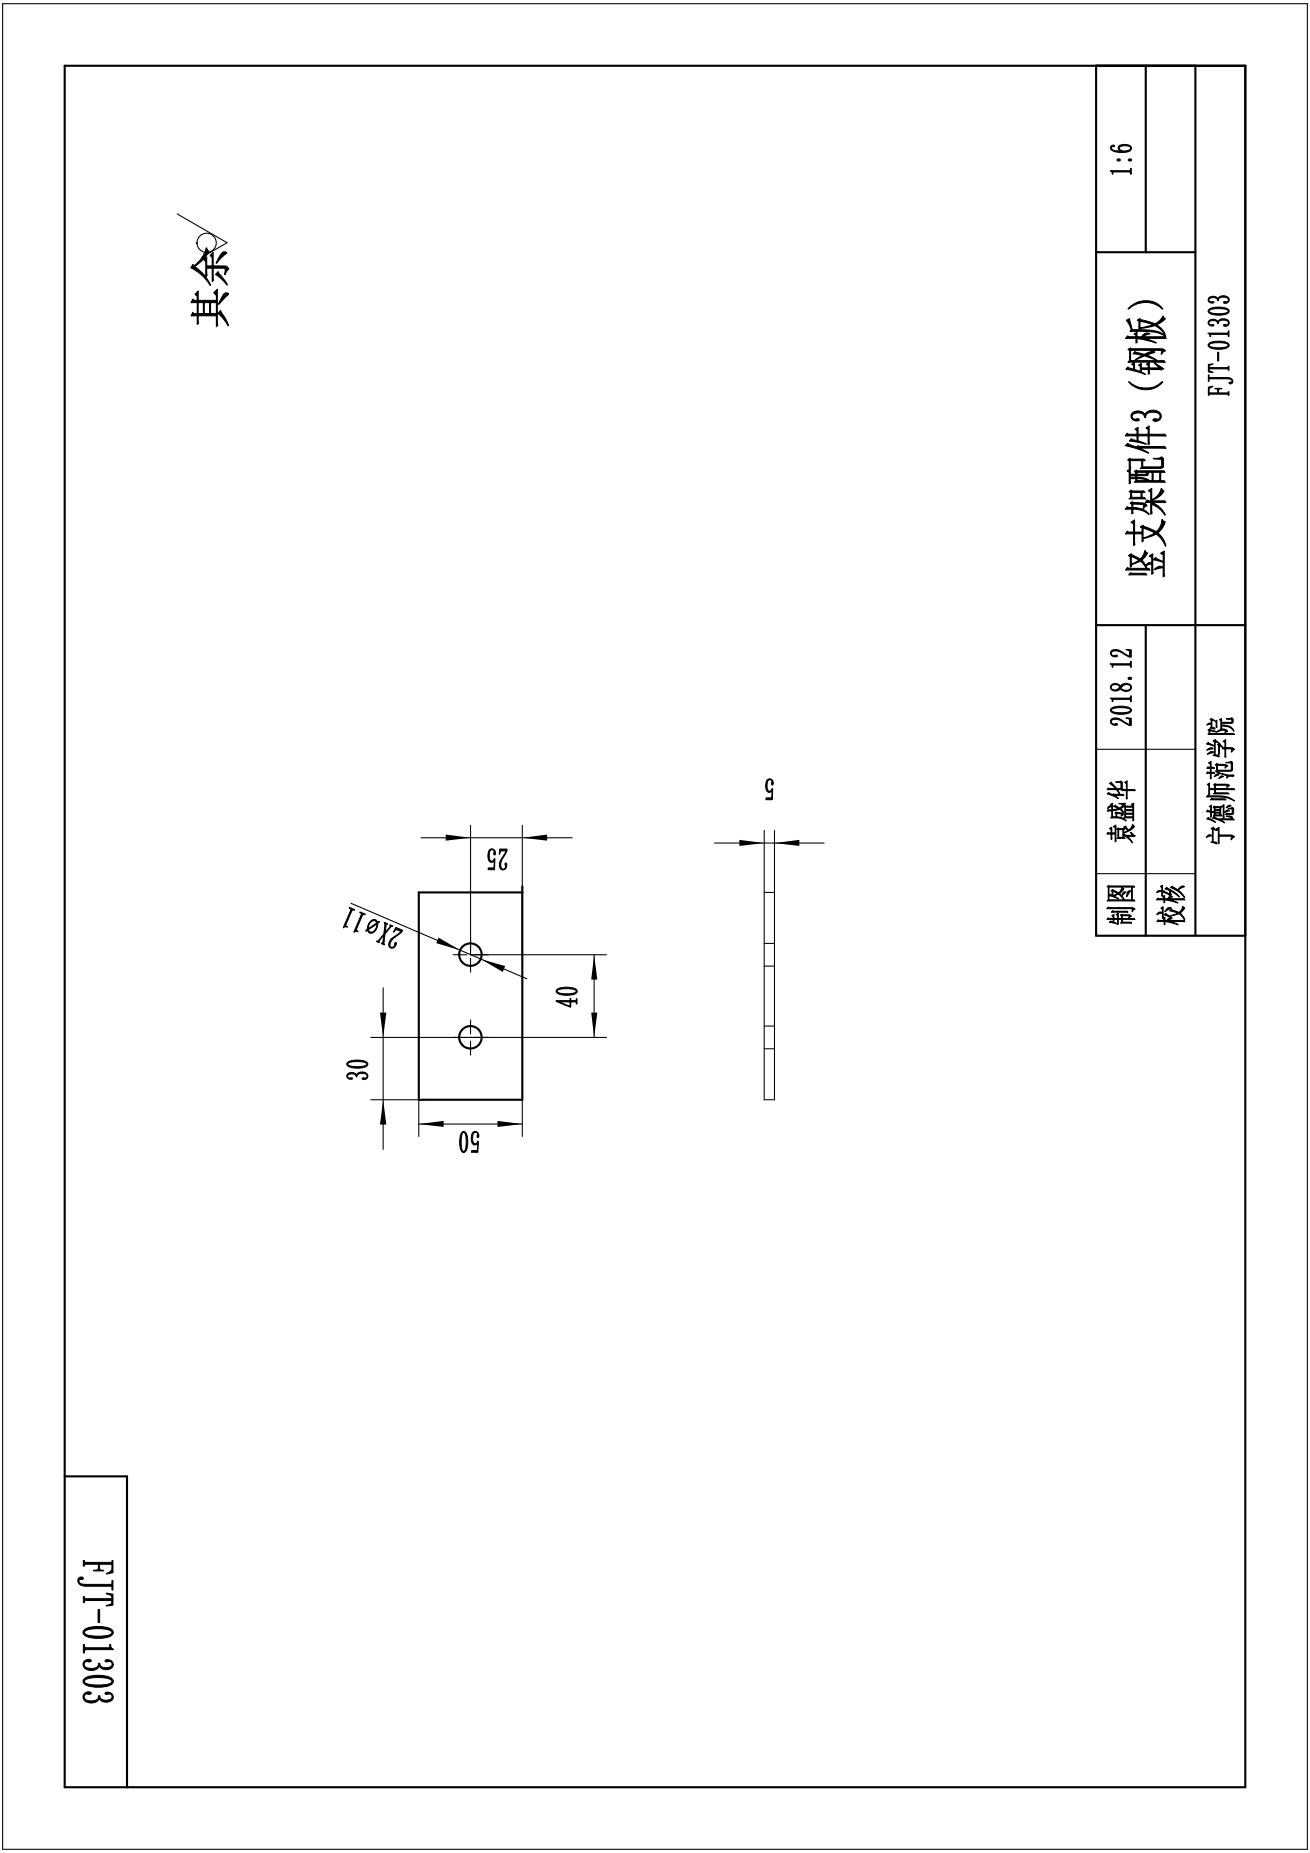
[picture p96: page 1]
