Capful/Graduation_Project/堆肥发酵塔设计/堆肥发酵塔2D图/2D PDF/FJT-02101(摆动叶叶片).pdf

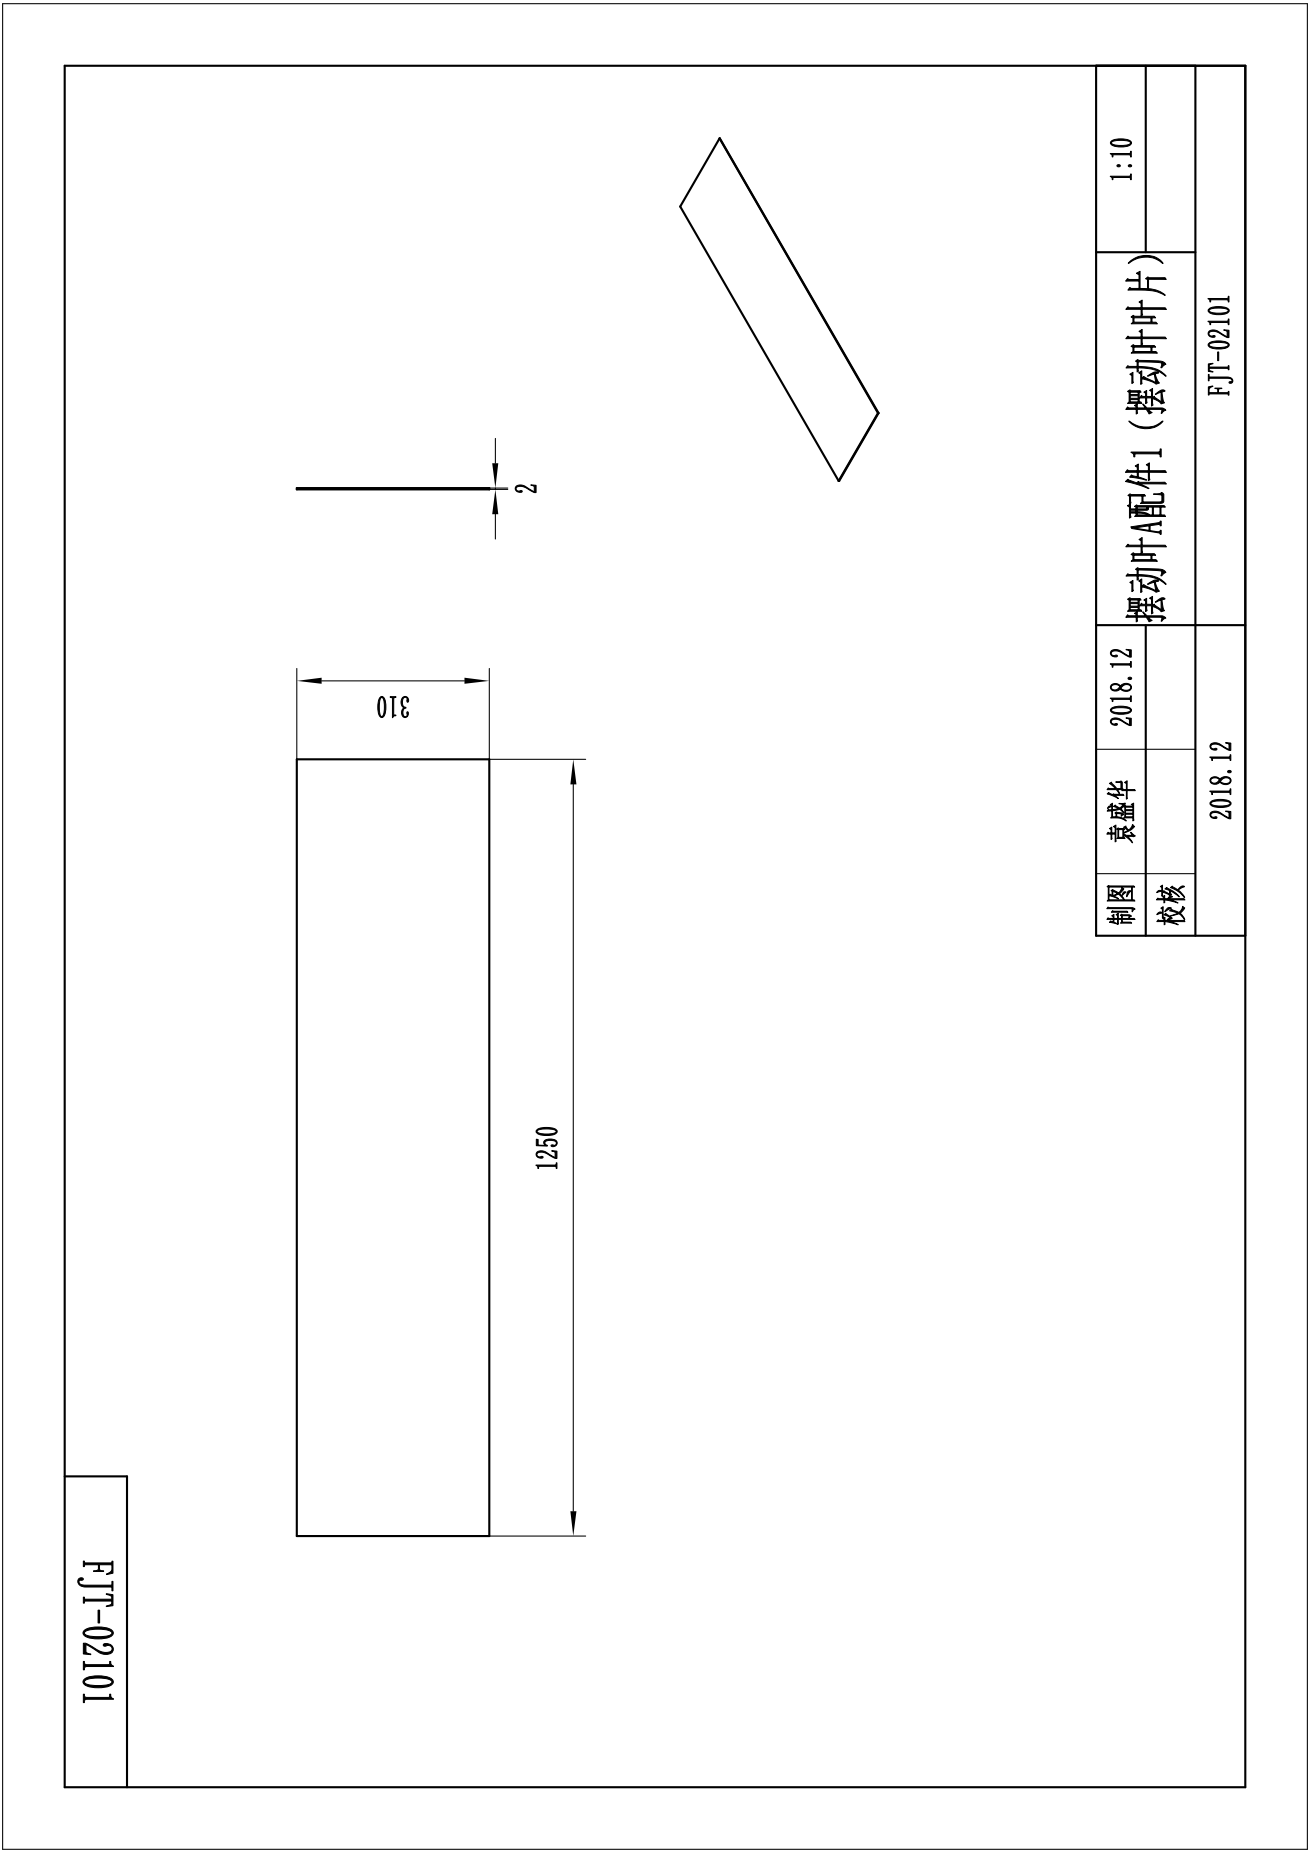
[picture p98: page 1]
