Capful/Graduation_Project/堆肥发酵塔设计/堆肥发酵塔2D图/2D PDF/FJT-02102(空心管).pdf

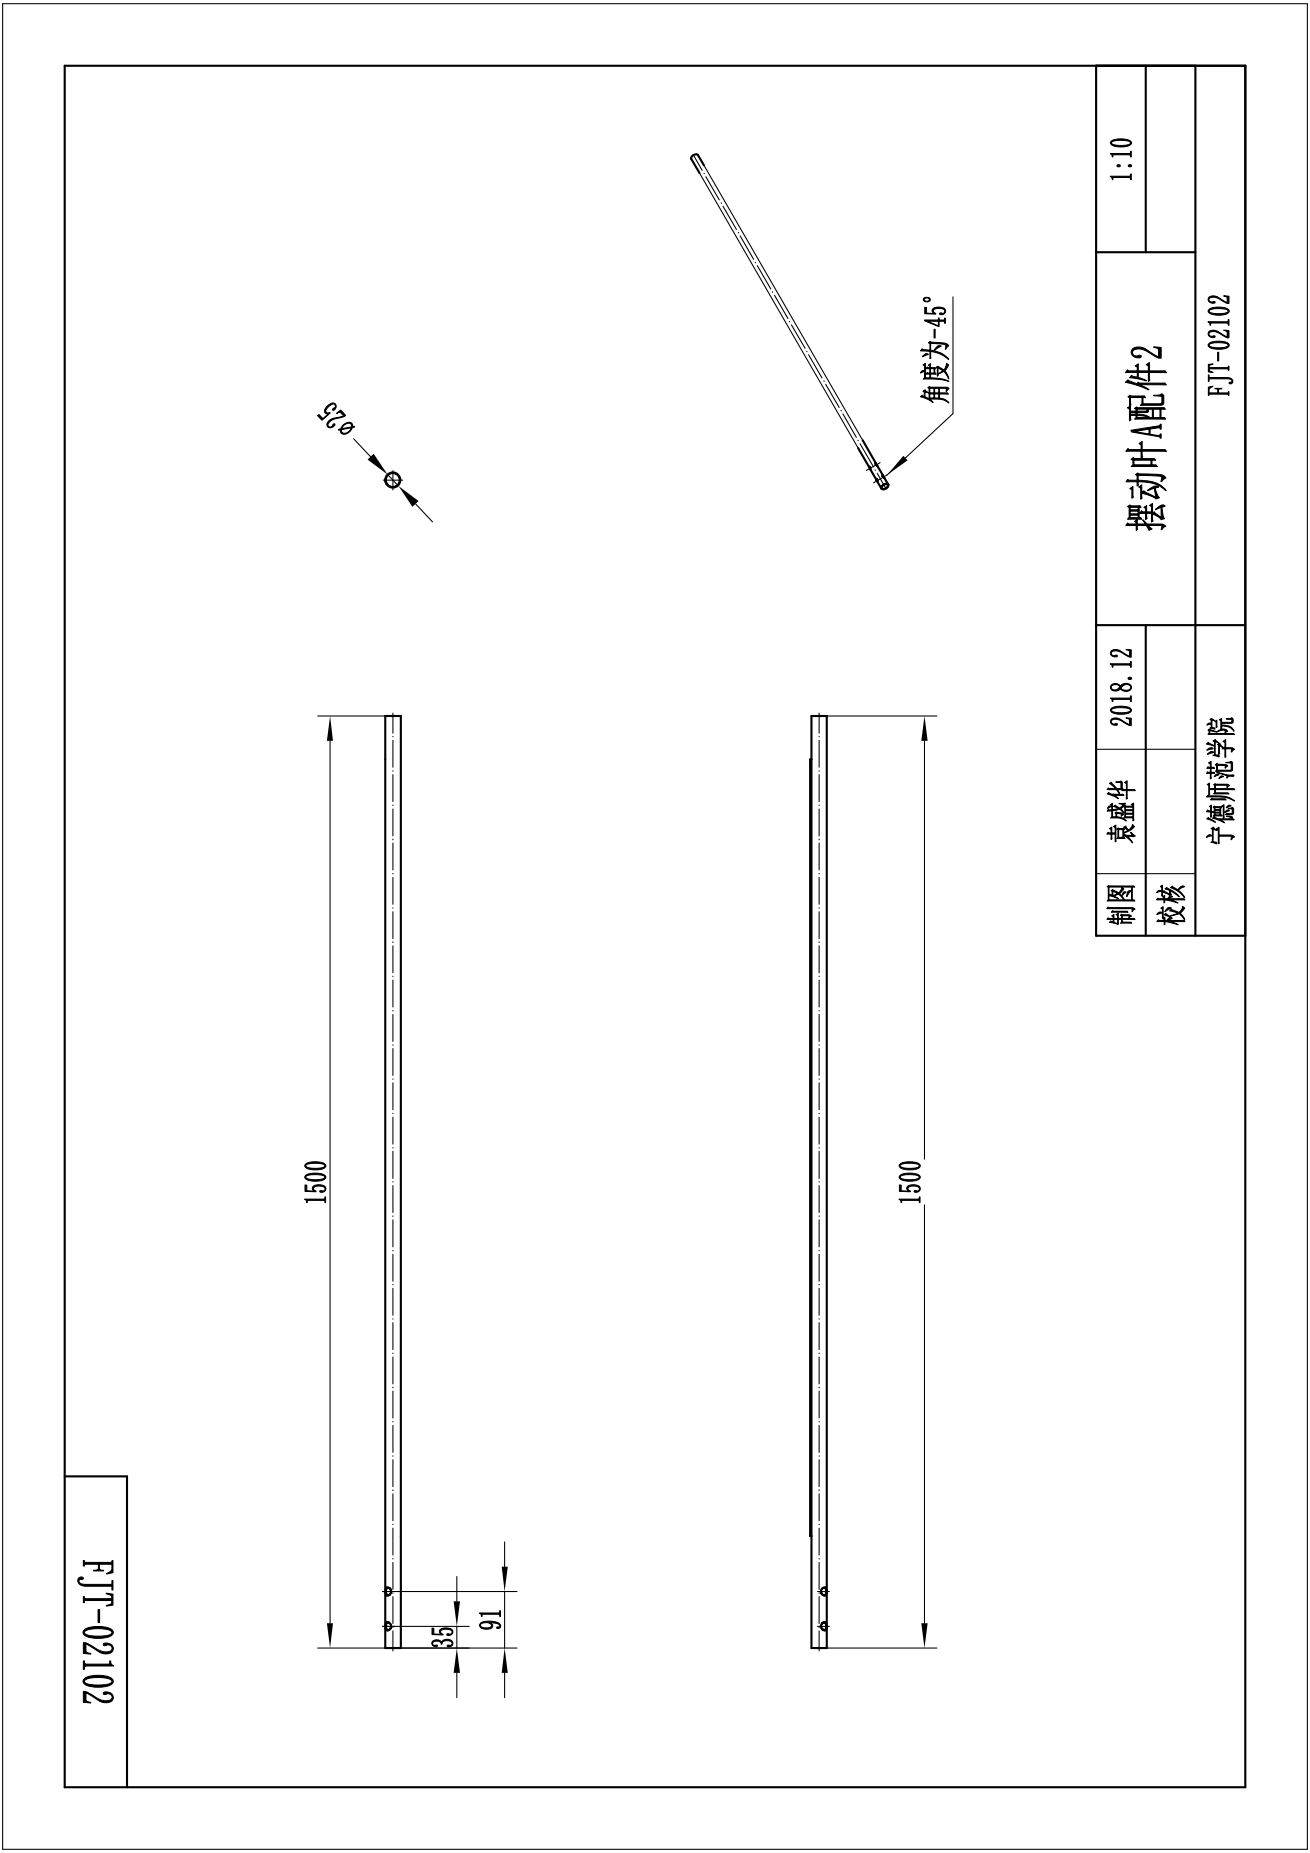
[picture p99: page 1]
