Capful/Graduation_Project/堆肥发酵塔设计/堆肥发酵塔2D图/2D PDF/FJT-02200(摆动叶B).pdf

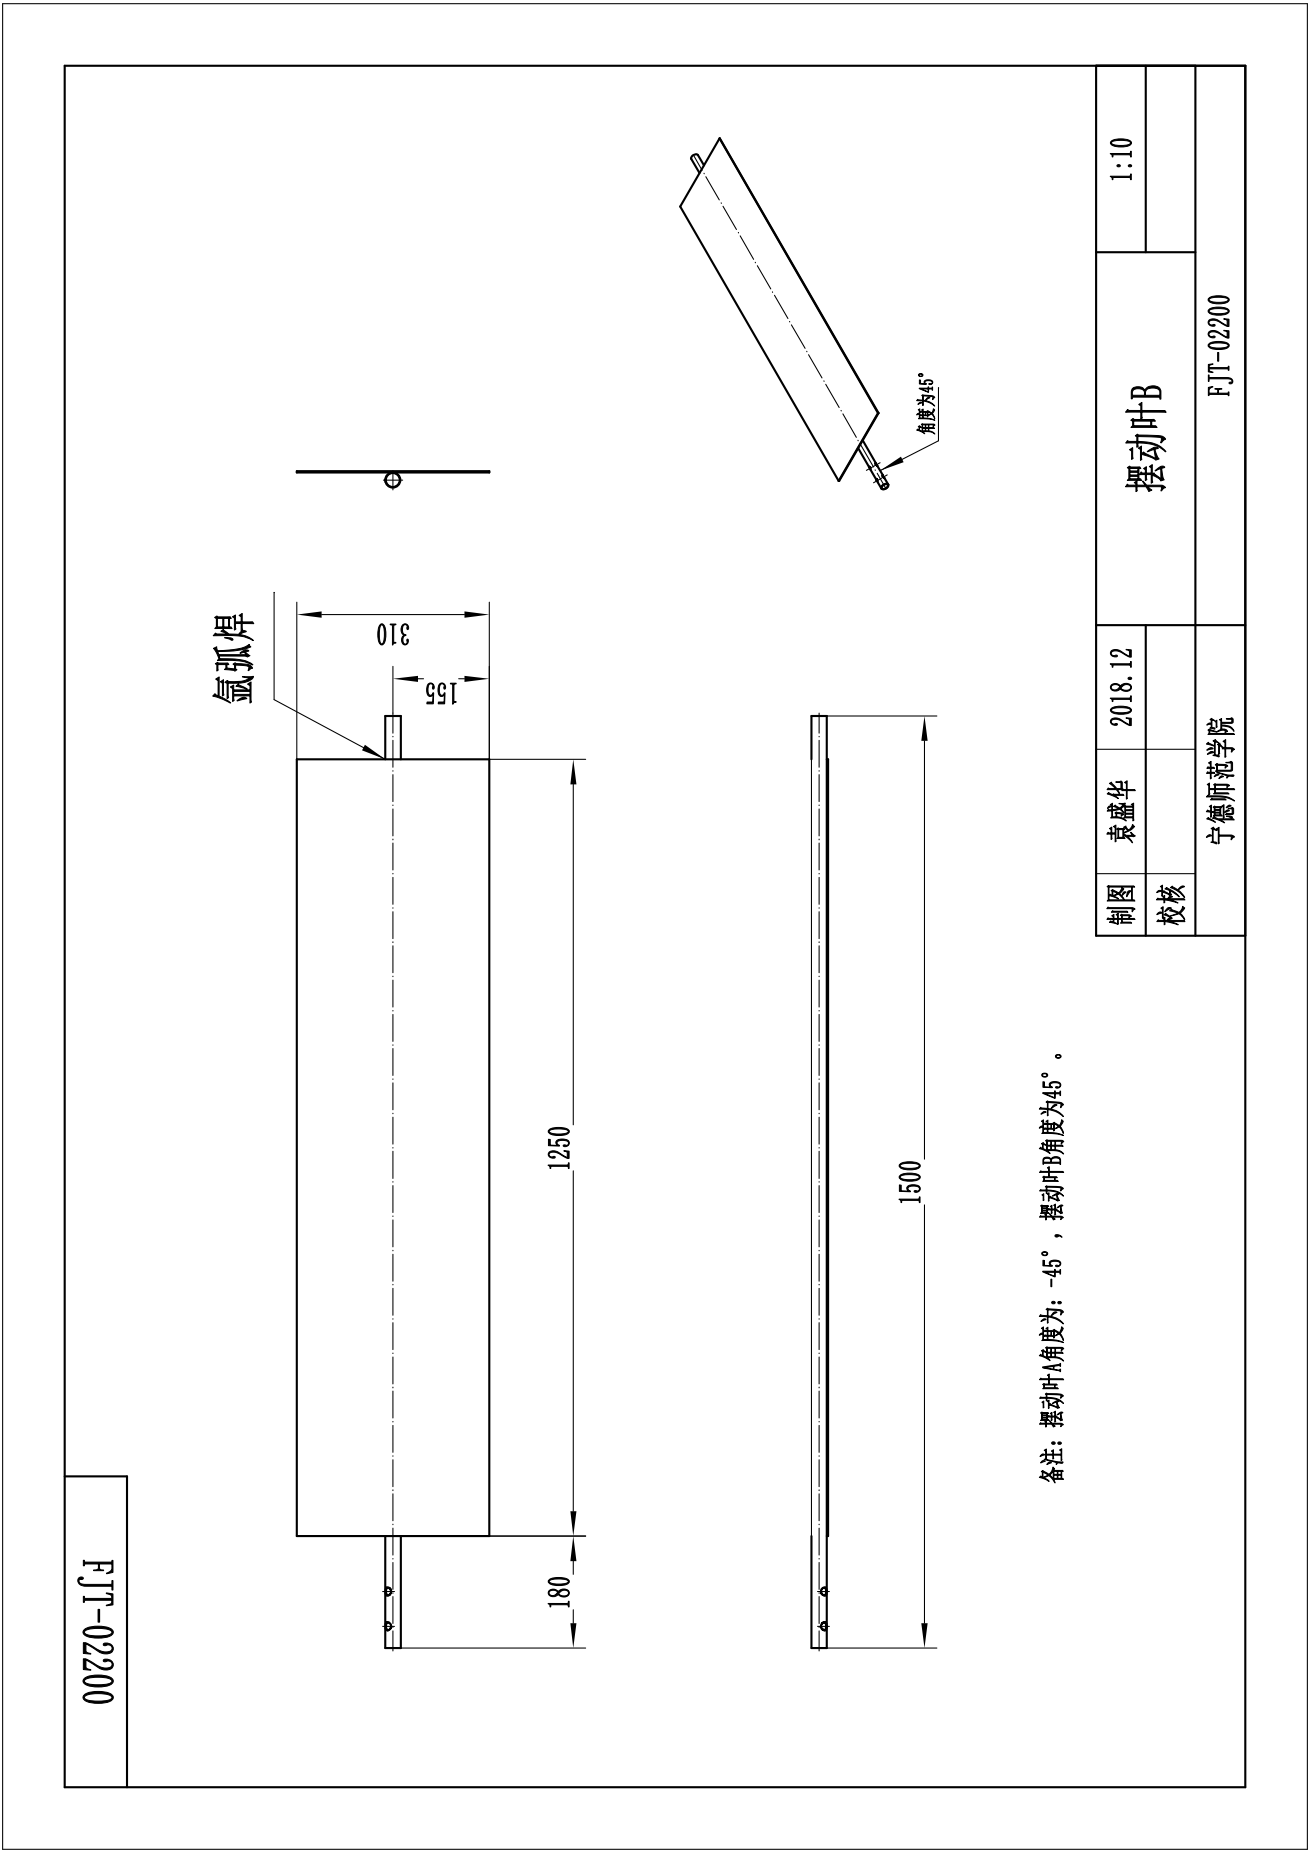
[picture p100: page 1]
