Capful/Graduation_Project/堆肥发酵塔设计/堆肥发酵塔2D图/2D PDF/FJT-02201(摆动叶叶片).pdf

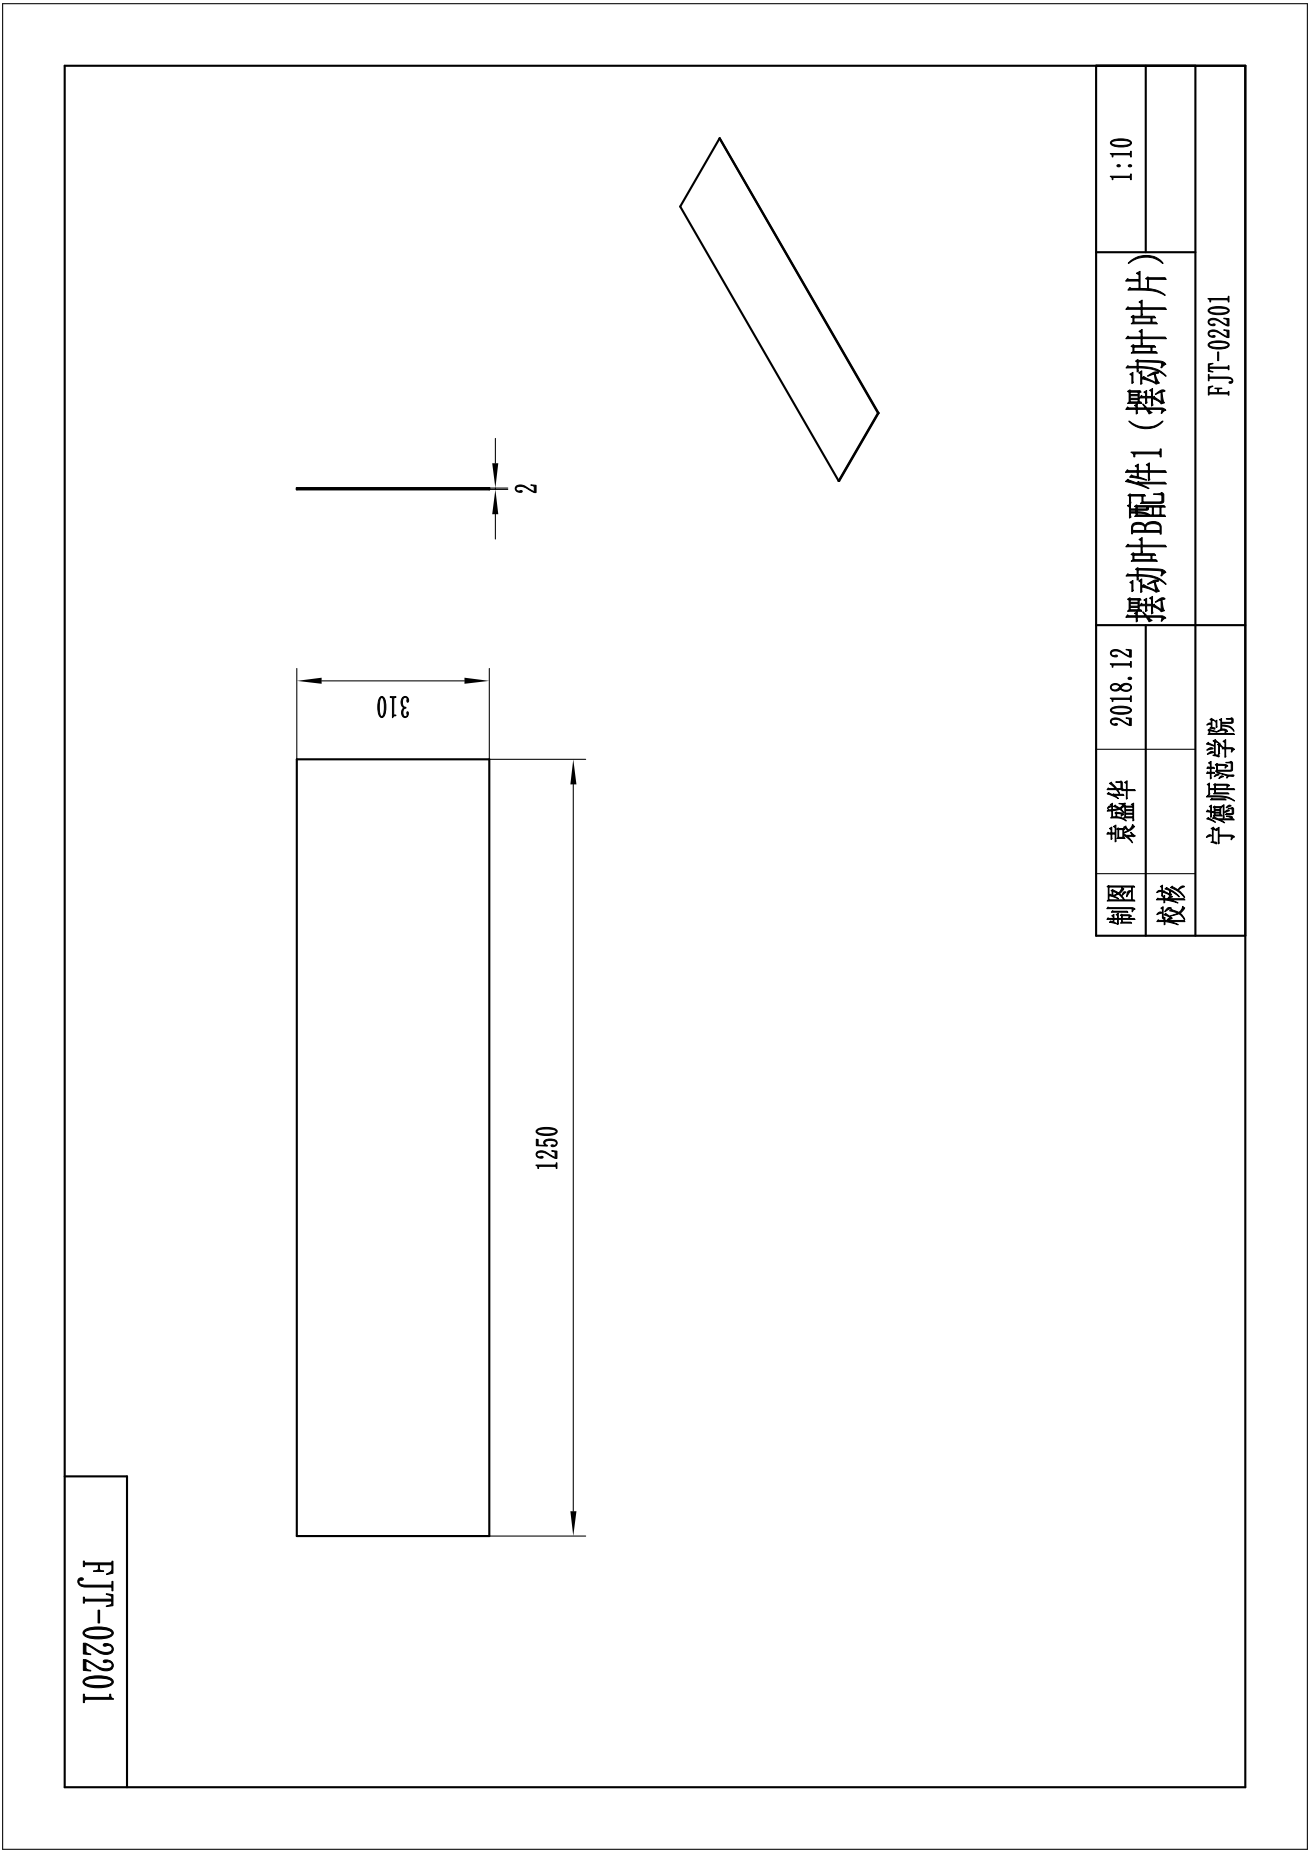
[picture p101: page 1]
