Capful/Graduation_Project/堆肥发酵塔设计/堆肥发酵塔2D图/2D PDF/FJT-02202(空心管).pdf

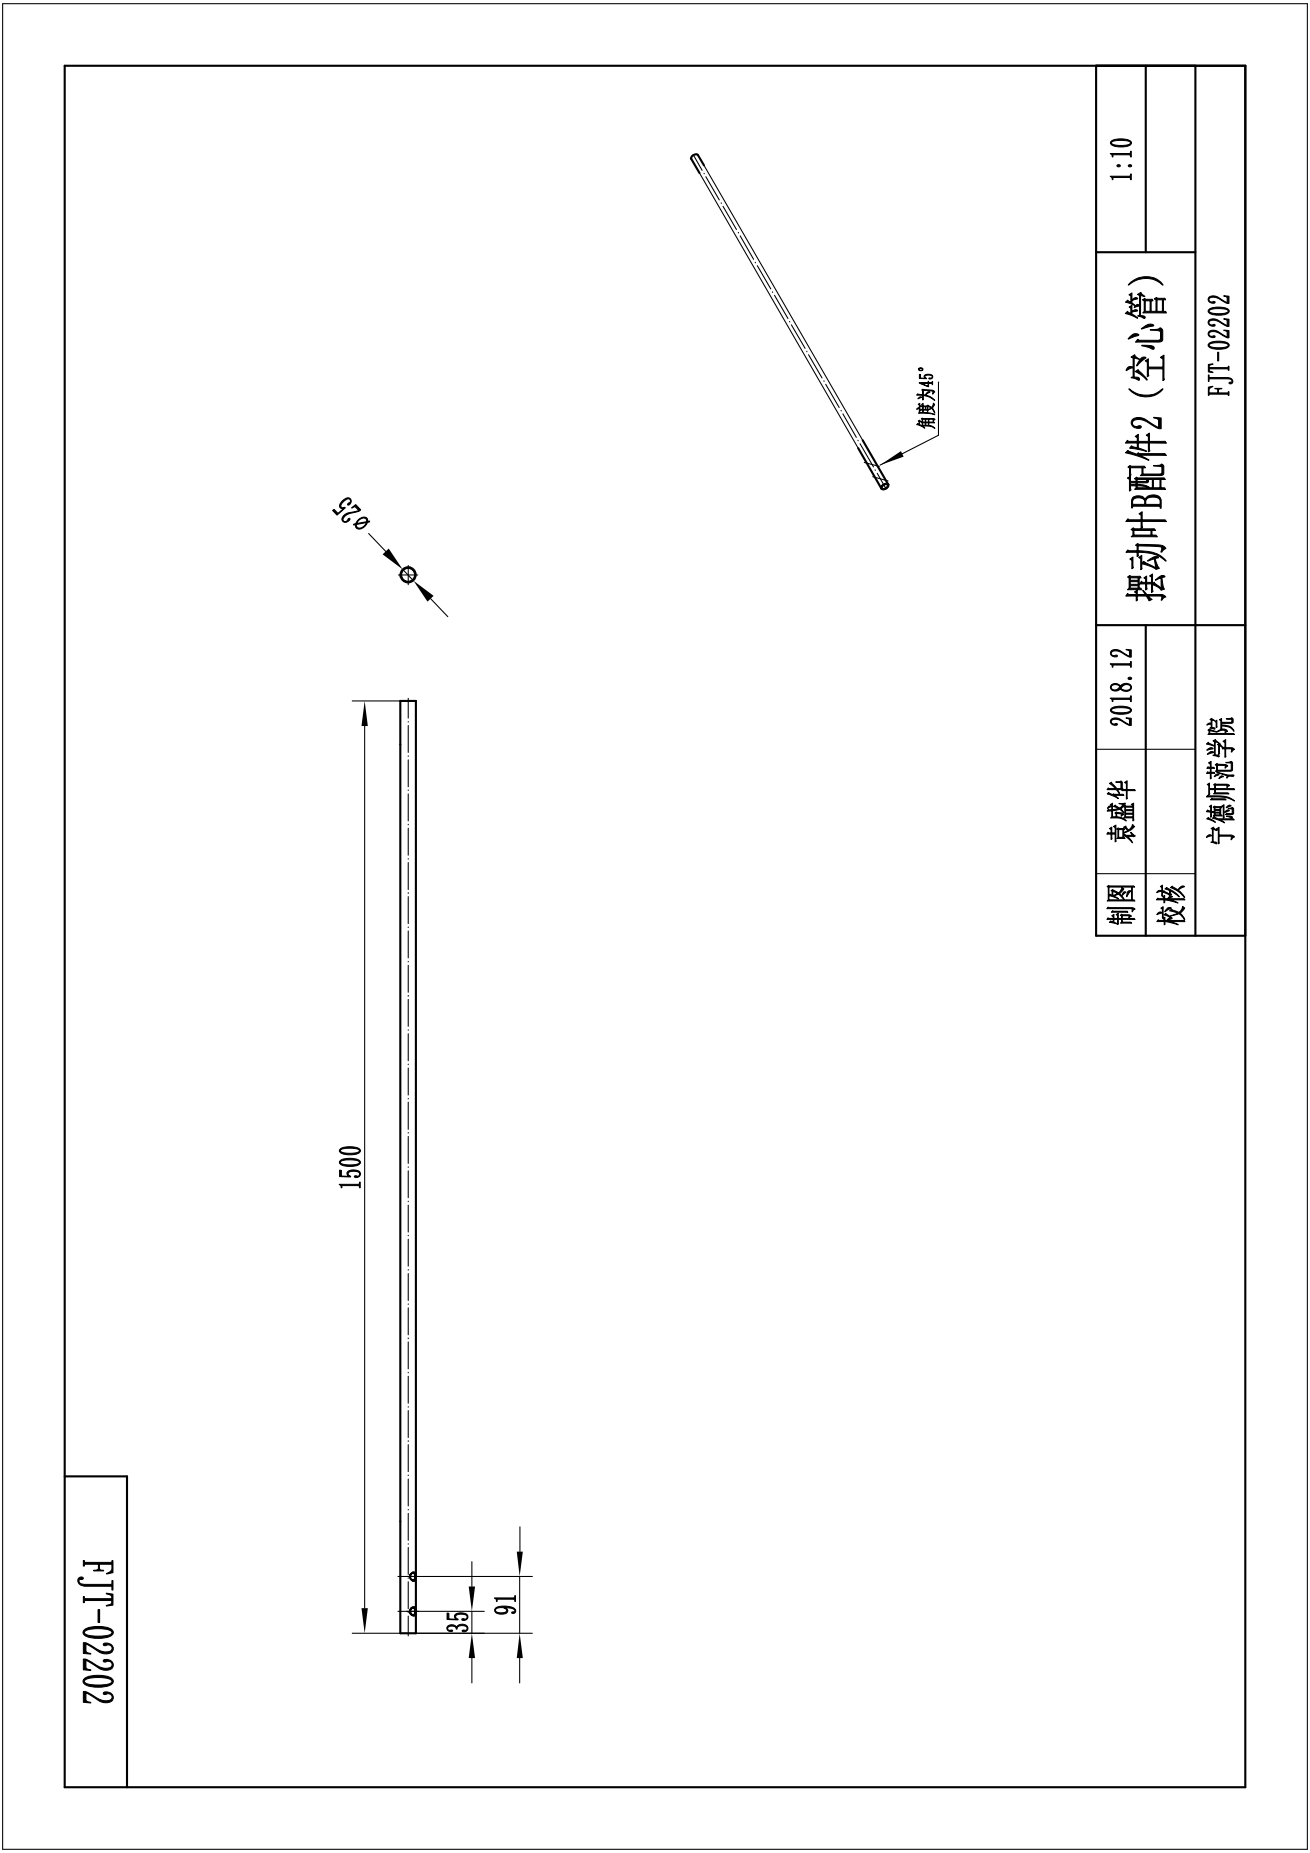
[picture p102: page 1]
