Capful/Graduation_Project/(commit log)

2018-10-10 添加模板
2018-10-10 添加3D 2D图
    [3D堆肥发酵塔.prt, 63X35X250液压缸.prt, M10X20螺栓.prt, M10X30螺杆.prt, M10X30螺栓-2.prt, M10X30螺栓-3.prt, M10X30螺栓.prt, M10X40螺杆.prt]
2018-10-25 Update 堆肥发酵塔设计/20170513149 袁盛华 指导过程记录表.doc
2018-12-25 ANSYS-截图
2019-01-01 Update 20170513149 袁盛华 论文.doc
2019-01-03 2019-1-3
    1.查重，最终查重率为13.5%
    2.删除第二章2.1小结“了解有机肥”，修改为“如何发酵有机肥”
    3.目录按学校要求对齐
    4.章节加粗
    5.添加参考文献
    6.修改第3.2.3章节格式
    7.添加附录
2019-01-03 CAD修改
    [FJT-01300(竖支架).dwg]
2019-01-04 2019-1-4
    1.目录中间空4格，下面空一格
    2.英文摘要Key words小改成小四号，修正空格过大问题
    3.修改3.1.1表格查重
    4.图3-2 位置调整
    5.修改装配图标识“-”改为“—”
2019-01-07 2019-1-7
    1.修改部分字符错误
    2.修改七层为六层
2019-01-07 PPT素材
